JMUWRobotics/AMADEE-27/charging_station/KiCad/PIHAT/jlcpcb/production_files/BOM-PIHAT.csv

Comment | Designator | Footprint | LCSC | Quantity
100nF | C5 | C_0603_1608Metric | C14663 | 1
1nF | C4 | C_0603_1608Metric | C1588 | 1
470 | R1,R10,R11,R12,R13,R14,R16,R17,R20,R21,R22,R7,R8 | R_0603_1608Metric | C23179 | 13
5.1k | R15,R18,R19,R2,R3,R4,R5,R6,R9 | R_0603_1608Metric | C23186 | 9
5v(Vin) | J1 | TerminalBlock_Phoenix_PT-1,5-2-5.0-H_1x02_P5.00mm_Horizontal | C3819953 | 1
AO3400A | Q1,Q11,Q6,Q8 | SOT-23 | C20917 | 4
AO3401A | Q10,Q2,Q7,Q9 | SOT-23 | C15127 | 4
D_Schottky | D2 | D_SOD-323 | C7420360 | 1
GPIO | J9 | PinSocket_2x20_P2.54mm_Vertical | C6235776 | 1
IM03GR | U4 | RELAY-SMD_IMXXGR | C2153100 | 1
KT-0805G | D5,D6,D7 | LED_0805_2012Metric | C2297 | 3
KT-0805Y | D8 | LED_0805_2012Metric | C2296 | 1
M7 | D1 | D_SMA | C95872 | 1
MPPT | J2 | TerminalBlock_Phoenix_PT-1,5-2-5.0-H_1x02_P5.00mm_Horizontal | C3819953 | 1
MSK12C02G25-B | U1,U2,U3,U5 | SW-SMD_MSK12C02G25-B | C22435663 | 4
NCD0805R1 | D4 | LED_0805_2012Metric | C84256 | 1
PS | J3 | TerminalBlock_Phoenix_PT-1,5-2-5.0-H_1x02_P5.00mm_Horizontal | C3819953 | 1
RFID0 | J4 | JST_XH_S7B-XH-A_1x07_P2.50mm_Horizontal | C157916 | 1
RFID1 | J5 | JST_XH_S7B-XH-A_1x07_P2.50mm_Horizontal | C157916 | 1
RFID2 | J6 | JST_XH_S7B-XH-A_1x07_P2.50mm_Horizontal | C157916 | 1
Raspberry Control Signals | J7 | JST_XH_S7B-XH-A_1x07_P2.50mm_Horizontal | C157916 | 1
TLP293 | U10,U11,U12,U6,U8,U9 | SOIC-4_4.55x2.6mm_P1.27mm | C3008594 | 6
TPS3430WDRC | U7 | VSON-10-1EP_3x3mm_P0.5mm_EP1.65x2.4mm | C2870545 | 1
WD_F | J8 | TerminalBlock_Phoenix_PT-1,5-2-5.0-H_1x02_P5.00mm_Horizontal | C3819953 | 1
