JMUWRobotics/AMADEE-27/charging_station/KiCad/PIHAT/jlcpcb/production_files/BOM-PIHAT-rounded.csv

Comment | Designator | Footprint | LCSC | Quantity
100nF | C2,C5 | C_0603_1608Metric | C14663 | 2
10k | R4,R5,R6 | R_0805_2012Metric_Pad1.20x1.40mm_HandSolder | C17414 | 3
1nF | C4 | C_0603_1608Metric | C1588 | 1
200 | R10,R11,R3,R8,R9 | R_0603_1608Metric | C8218 | 5
5v(Vin) | J1 | TerminalBlock_Phoenix_PT-1,5-2-5.0-H_1x02_P5.00mm_Horizontal | C5188434 | 1
AO3400A | Q2,Q5,Q6,Q8 | SOT-23 | C20917 | 4
AO3401A | Q1,Q3,Q4,Q7 | SOT-23 | C15127 | 4
D_Schottky | D2 | D_SOD-323 | C7420360 | 1
GPIO | J9 | PinSocket_2x20_P2.54mm_Vertical | C6235776 | 1
Heartbeat | D5 | LED_0805_2012Metric | C2297 | 1
IM03GR | U4 | RELAY-SMD_IMXXGR | C2153100 | 1
M7 | D1 | D_SMA | C95872 | 1
MPPT | J2 | TerminalBlock_Phoenix_PT-1,5-2-5.0-H_1x02_P5.00mm_Horizontal | C5188434 | 1
MSK12C02G25-B | U1,U2,U3 | SW-SMD_MSK12C02G25-B | C22435663 | 3
PS | J3 | TerminalBlock_Phoenix_PT-1,5-2-5.0-H_1x02_P5.00mm_Horizontal | C5188434 | 1
RFID0 | J4 | JST_XH_S7B-XH-A_1x07_P2.50mm_Horizontal | C157916 | 1
RFID1 | J5 | JST_XH_S7B-XH-A_1x07_P2.50mm_Horizontal | C157916 | 1
RFID2 | J6 | JST_XH_S7B-XH-A_1x07_P2.50mm_Horizontal | C157916 | 1
Raspberry Control Signals | J7 | JST_XH_S7B-XH-A_1x07_P2.50mm_Horizontal | C157916 | 1
TLV809EA29DBZR | U6 | SOT-23-3_L2.9-W1.3-P0.95-LS2.4-BR | C1852110 | 1
TPS3430WDRC | U7 | VSON-10-1EP_3x3mm_P0.5mm_EP1.65x2.4mm | C2870545 | 1
WDO | D4 | LED_0805_2012Metric | C84256 | 1
WD_F | J8 | TerminalBlock_Phoenix_PT-1,5-2-5.0-H_1x02_P5.00mm_Horizontal | C5188434 | 1
WD_LED_EN | D3 | LED_0805_2012Metric | C2296 | 1
~{WDO} | TP3 | TestPoint_Pad_D1.0mm |  | 1
WD_EN | TP2 | TestPoint_Pad_D1.0mm |  | 1
SET0 | TP1 | TestPoint_Pad_D1.0mm |  | 1
