JMUWRobotics/AMADEE-27/charging_station/KiCad/SLCU/jlcpcb/production_files/BOM-TowerLightPCB.csv

Comment | Designator | Footprint | LCSC | Quantity
1.5k | R10,R11,R12,R13,R15,R16,R17,R18,R19,R20,R21,R22,R23,R24,R25,R26,R27,R4,R5,R6,R7,R8,R9 | R_0805_2012Metric_Pad1.20x1.40mm_HandSolder | C4310 | 23
100n | C10,C11,C4 | C_0805_2012Metric_Pad1.18x1.45mm_HandSolder | C49678 | 3
100nF X7R >16V | C6 | C_0805_2012Metric | C49678 | 1
10k | RN2,RN7,RN8,RN9 | RES-ARRAY-SMD_0603-8P-L3.2-W1.6-BL | C29718 | 4
12uH | L1 | L_12x12mm_H8mm | C338772 | 1
1k | RN1,RN3,RN4,RN5,RN6 | RES-ARRAY-SMD_0603-8P-L3.2-W1.6-BL | C20197 | 5
2.7k 1% | R3 | R_0805_2012Metric_Pad1.20x1.40mm_HandSolder | C17530 | 1
22uF X7R >25V | C7,C8,C9 | C_0805_2012Metric_Pad1.18x1.45mm_HandSolder | C45783 | 3
2N7002 | Q10,Q11,Q12,Q13,Q14,Q15,Q16,Q17,Q18,Q19,Q2,Q20,Q21,Q22,Q23,Q24,Q25,Q26,Q27,Q28,Q29,Q3,Q30,Q4,Q5,Q6,Q7,Q8,Q9 | SOT-323_SC-70 | C7420322 | 29
4.7uF X7R >50V ~10mOhm | C5 | C_1206_3216Metric | C29823 | 1
51k | R14 | R_0805_2012Metric_Pad1.20x1.40mm_HandSolder | C17737 | 1
51k 1% | R2 | R_0805_2012Metric_Pad1.20x1.40mm_HandSolder | C17737 | 1
BAT54CDW | D13,D15,D19,D24,D30,D5,D8 | SOT-363_SC-70-6 | C49190672 | 7
CD4028BNSR | U2 | SOIC127P780X200-16N | C131484 | 1
CD4069UBNSR | U3 | SOIC127P780X200-14N | C2866535 | 1
Contact Signals | J2 | TerminalBlock_Phoenix_MKDS-1,5-4_1x04_P5.00mm_Horizontal | C3817931 | 1
E-STOP | D7 | LED_0805_2012Metric_Pad1.15x1.40mm_HandSolder | C84256 | 1
EN_LOGIC | D17 | LED_0805_2012Metric_Pad1.15x1.40mm_HandSolder | C2297 | 1
Enable Logic | SW1 | SW-SMD_SHOUHAN_MST-22D18G23J_C2875122 | C2875122 | 1
F1 | D16 | LED_0805_2012Metric_Pad1.15x1.40mm_HandSolder | C84256 | 1
F2 | D18 | LED_0805_2012Metric_Pad1.15x1.40mm_HandSolder | C84256 | 1
F3 | D20 | LED_0805_2012Metric_Pad1.15x1.40mm_HandSolder | C84256 | 1
F4 | D21 | LED_0805_2012Metric_Pad1.15x1.40mm_HandSolder | C84256 | 1
Input Power (24V) | J1 | TerminalBlock_Phoenix_MKDS-1,5-4_1x04_P5.00mm_Horizontal | C3817931 | 1
LED | D25,D26 | LED_0805_2012Metric_Pad1.15x1.40mm_HandSolder | C2296 | 2
LED | D27,D28,D29 | LED_0805_2012Metric_Pad1.15x1.40mm_HandSolder | C2297 | 3
LED | D22,D23 | LED_0805_2012Metric_Pad1.15x1.40mm_HandSolder | C84256 | 2
LMR51430 | U1 | SOT-23-6 | C5185863 | 1
Logic Power Out | J4 | TerminalBlock_Phoenix_MKDS-1,5-4_1x04_P5.00mm_Horizontal | C3817931 | 1
M7 | D1 | D_SMA | C95872 | 1
NOMINAL_ON | D14 | LED_0805_2012Metric_Pad1.15x1.40mm_HandSolder | C2297 | 1
PWR +12V | D4 | LED_0805_2012Metric_Pad1.15x1.40mm_HandSolder | C2297 | 1
PWR +24V | D3 | LED_0805_2012Metric_Pad1.15x1.40mm_HandSolder | C2297 | 1
READY | D6 | LED_0805_2012Metric_Pad1.15x1.40mm_HandSolder | C2297 | 1
Raspberry Control Signals | J3 | JST_XH_S7B-XH-A_1x07_P2.50mm_Horizontal | C157916 | 1
STOPPED | D11 | LED_0805_2012Metric_Pad1.15x1.40mm_HandSolder | C2297 | 1
Stack Light DOWN | J6 | TerminalBlock_Phoenix_MKDS-1,5-4_1x04_P5.00mm_Horizontal | C3817931 | 1
Stack Light UP | J5 | TerminalBlock_Phoenix_MKDS-1,5-4_1x04_P5.00mm_Horizontal | C3817931 | 1
WD | D9 | LED_0805_2012Metric_Pad1.15x1.40mm_HandSolder | C84256 | 1
XF-508P-A-B | F1 | FUSE-TH_XF-508P-A-B | C19727304 | 1
~{P1} | D12 | LED_0805_2012Metric_Pad1.15x1.40mm_HandSolder | C84256 | 1
~{P2} | D10 | LED_0805_2012Metric_Pad1.15x1.40mm_HandSolder | C84256 | 1
