JMUWRobotics/AMADEE-27/charging_station/QElectroTech/chargingStationV2.pdf

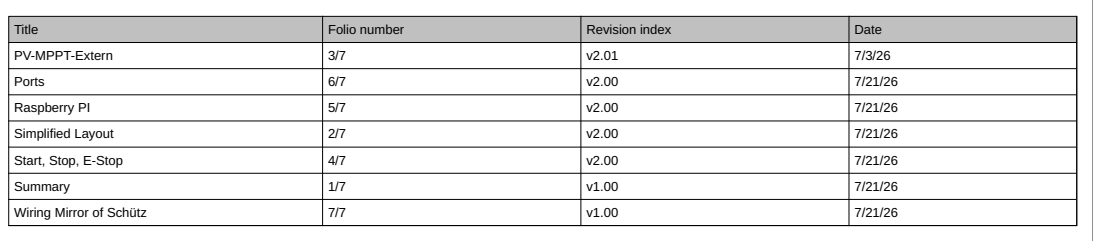
[picture p1: page 1]
Author:; Folio: 1/7; Date: 7/21/26; Summary; Save Date: 8/10/26; Revision: v1.00; PV-MPPT-Extern; Ports; Raspberry PI; Simplified Layout; Start, Stop, E-Stop; Wiring Mirror of Schütz; Title; Folio number; Revision index; Date

Charching Station AMADEE-27

File: ./charging_station/QElectroTech/chargingStation.qet

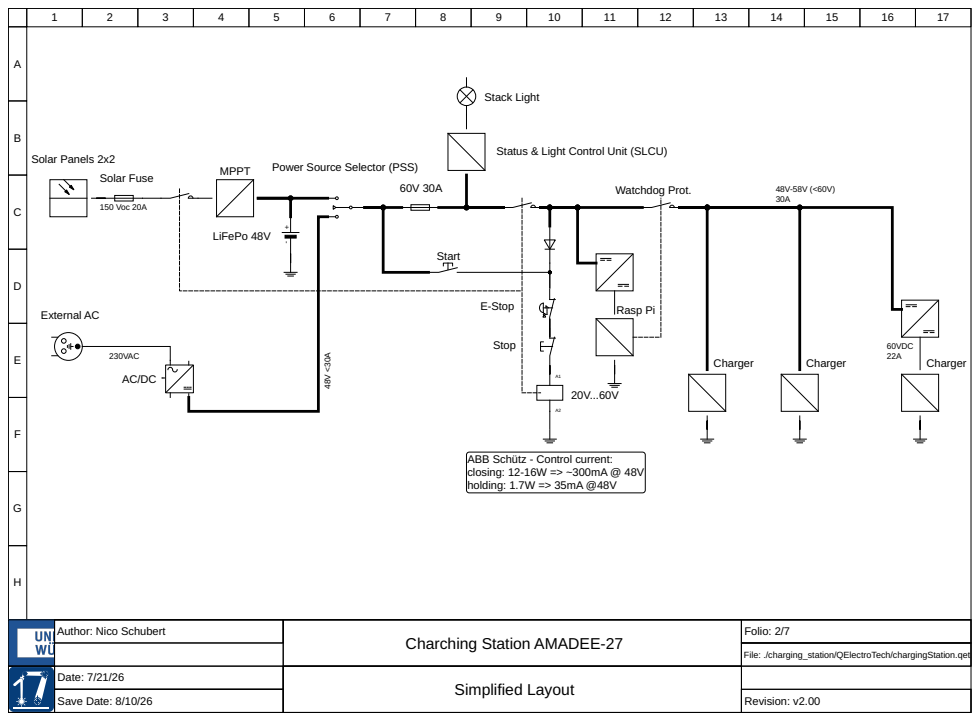
[picture p2: page 2]
Folio: 2/7; Date: 7/21/26; Simplified Layout; Save Date: 8/10/26; Revision: v2.00; Watchdog Prot.; Stop; Solar Panels 2x2; Charger; Start; Solar Fuse; MPPT; LiFePo 48V; Stack Light; 150 Voc 20A; 230VAC; 60VDC 22A; E-Stop

Status & Light Control Unit (SLCU)

Power Source Selector (PSS)

Rasp Pi External AC

ABB Schütz - Control current:
closing: 12-16W => ~300mA @ 48V
holding: 1.7W => 35mA @48V

Author: Nico Schubert

Charching Station AMADEE-27

File: ./charging_station/QElectroTech/chargingStation.qet

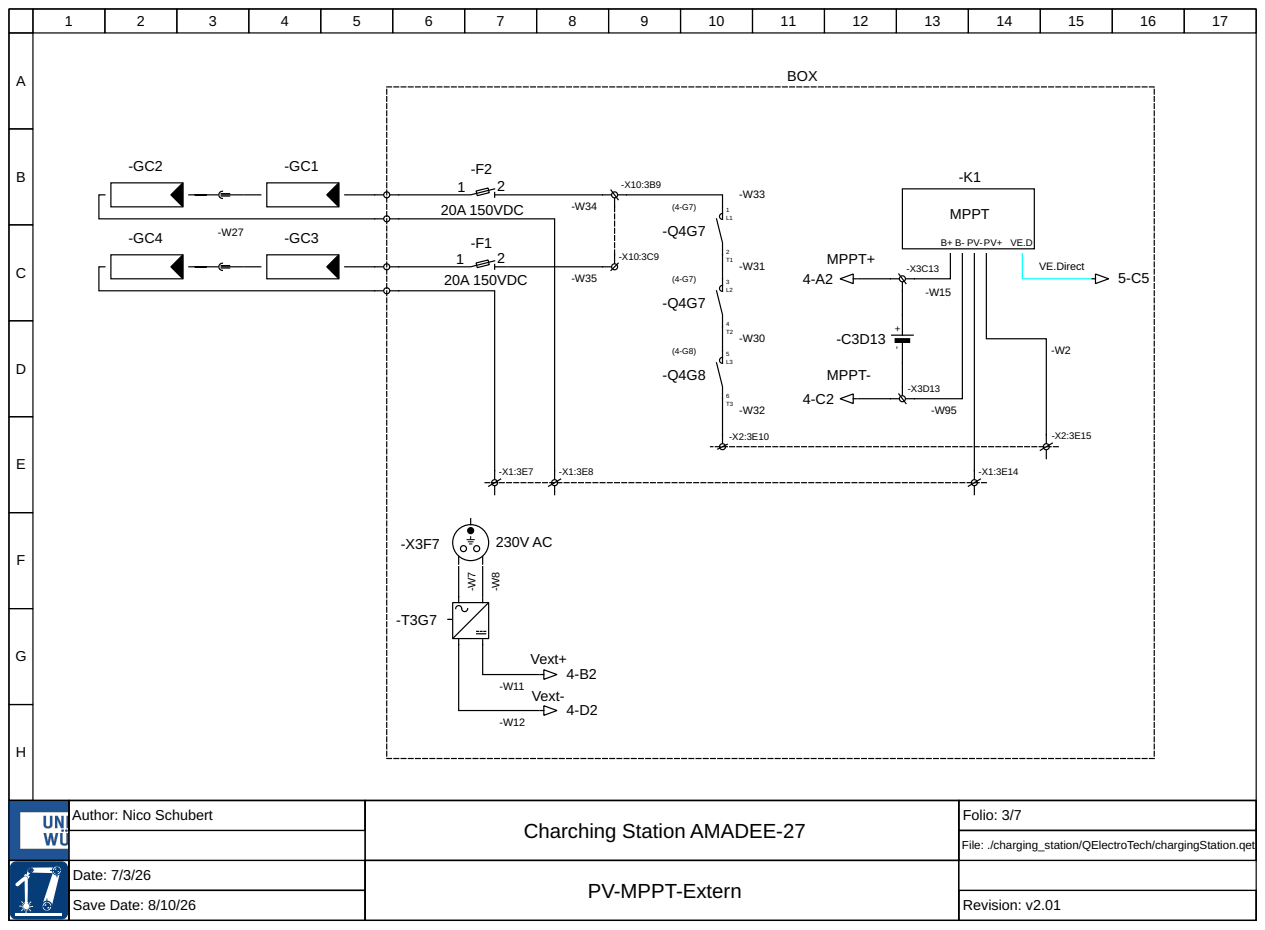
[picture p3: page 3]
Folio: 3/7; Date: 7/3/26; MPPT-; 20A 150VDC; MPPT; Vext-; MPPT+; Vext+; BOX; VE.Direct

Author: Nico Schubert

Charching Station AMADEE-27

File: ./charging_station/QElectroTech/chargingStation.qet

PV-MPPT-Extern

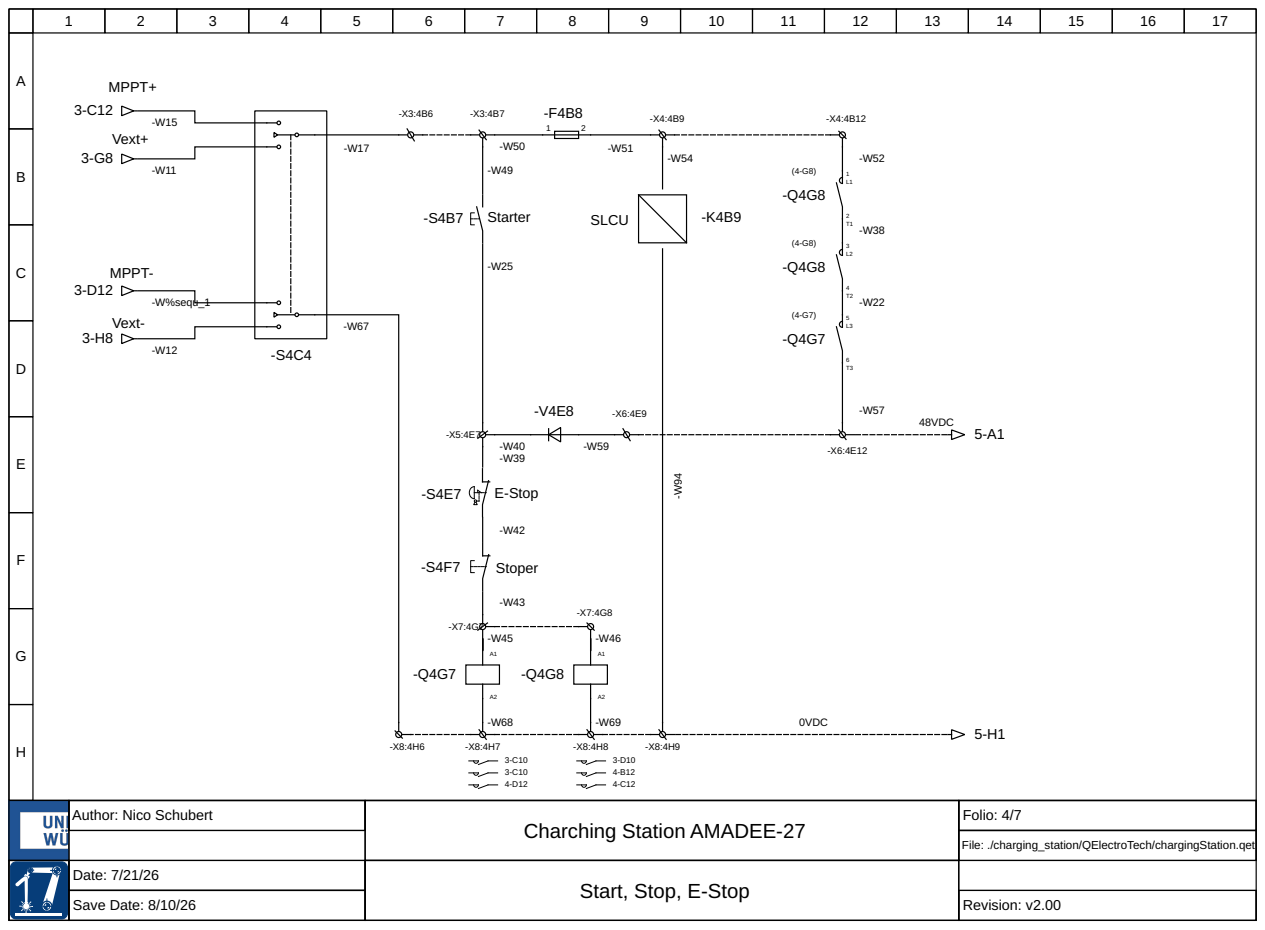
[picture p4: page 4]
Charching Station AMADEE-27; Folio: 4/7; Date: 7/21/26; MPPT+; Vext+; Vext-; MPPT-; E-Stop; Starter; Stoper; SLCU; -W%sequ_1; 48VDC; 0VDC

Author: Nico Schubert

File: ./charging_station/QElectroTech/chargingStation.qet

Start, Stop, E-Stop

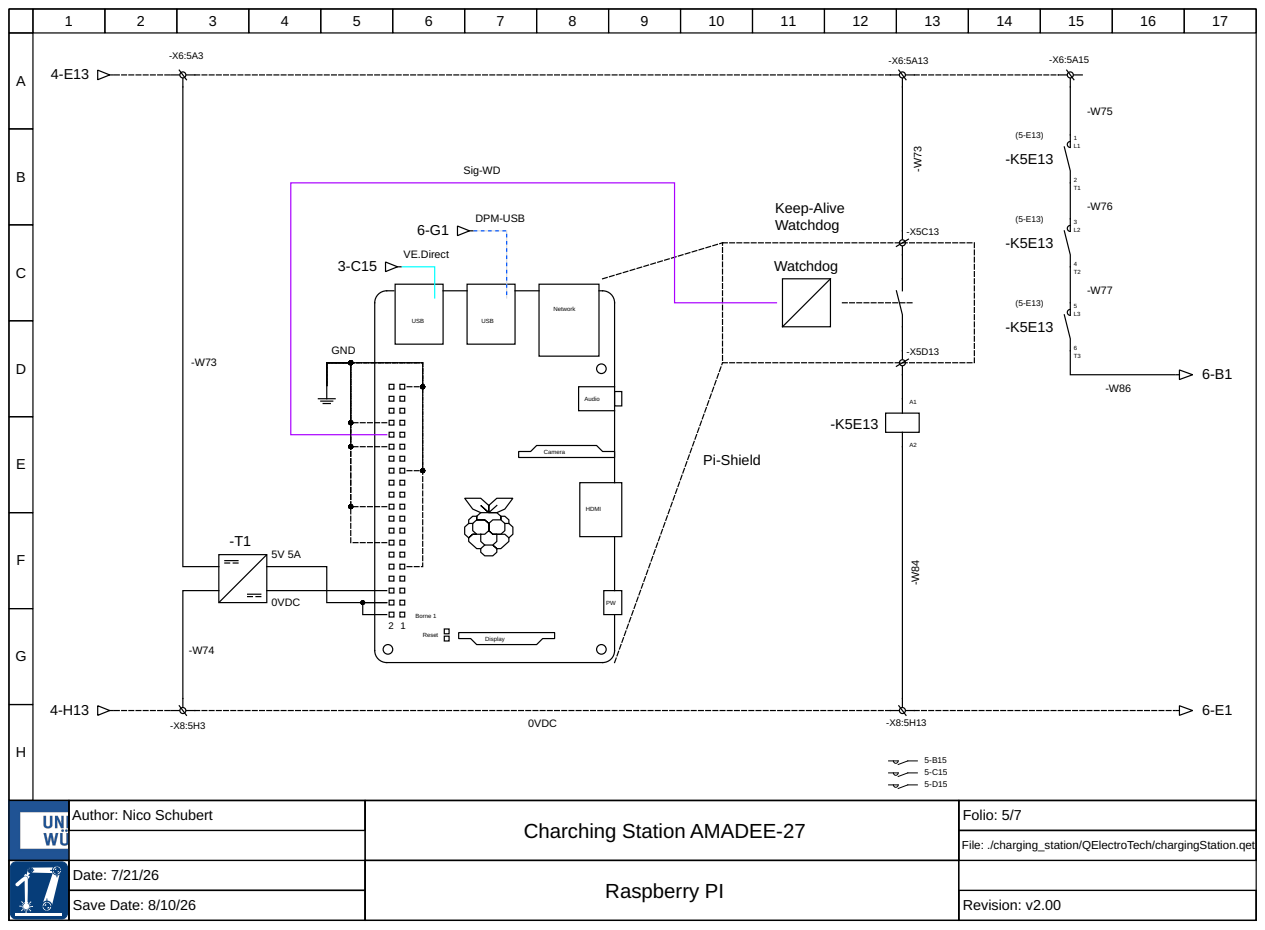
[picture p5: page 5]
Folio: 5/7; Date: 7/21/26; Raspberry PI; USB; Network; Audio; Camera; HDMI; Display; Borne 1; Reset; Watchdog; Keep-Alive Watchdog; Pi-Shield; DPM-USB; 0VDC; GND; Sig-WD; VE.Direct

Author: Nico Schubert

Charching Station AMADEE-27

File: ./charging_station/QElectroTech/chargingStation.qet

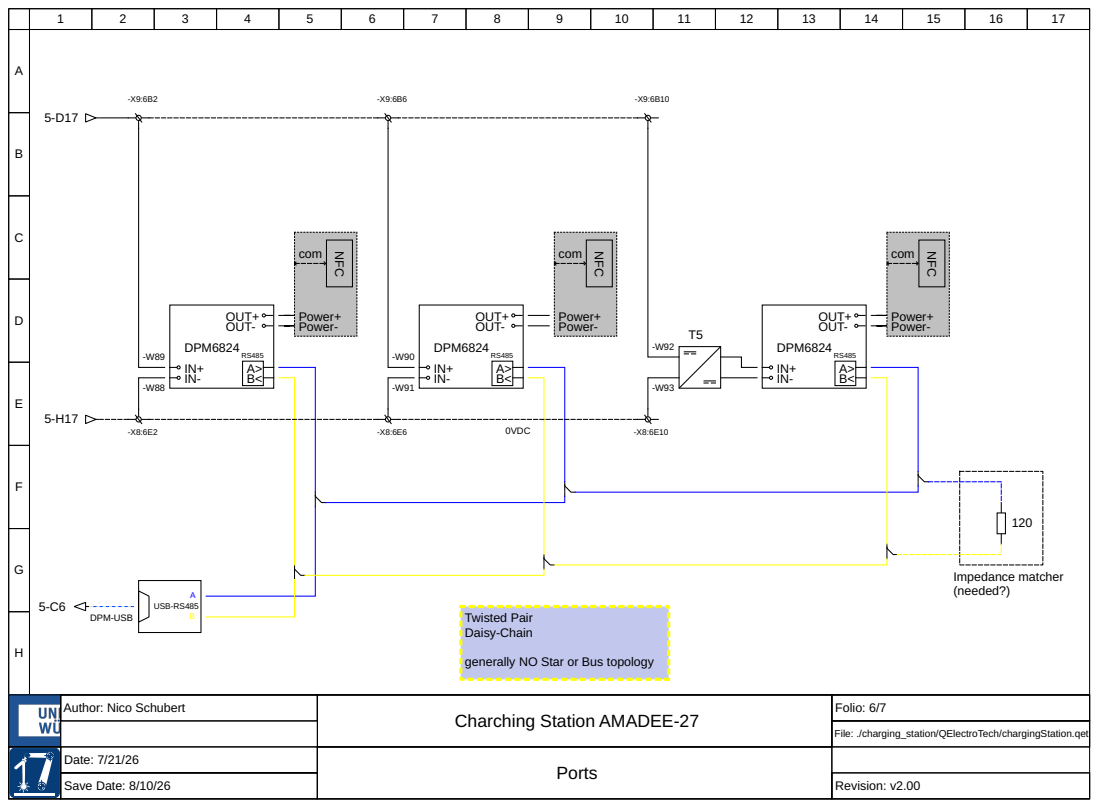
[picture p6: page 6]
Folio: 6/7; Date: 7/21/26; Ports; USB-RS485; Twisted Pair; Daisy-Chain; Impedance matcher (needed?); OUT+; OUT- RS485 DPM6824; Power+ Power-; NFC; com; DPM-USB; 0VDC

generally NO Star or Bus topology

Author: Nico Schubert

Charching Station AMADEE-27

File: ./charging_station/QElectroTech/chargingStation.qet

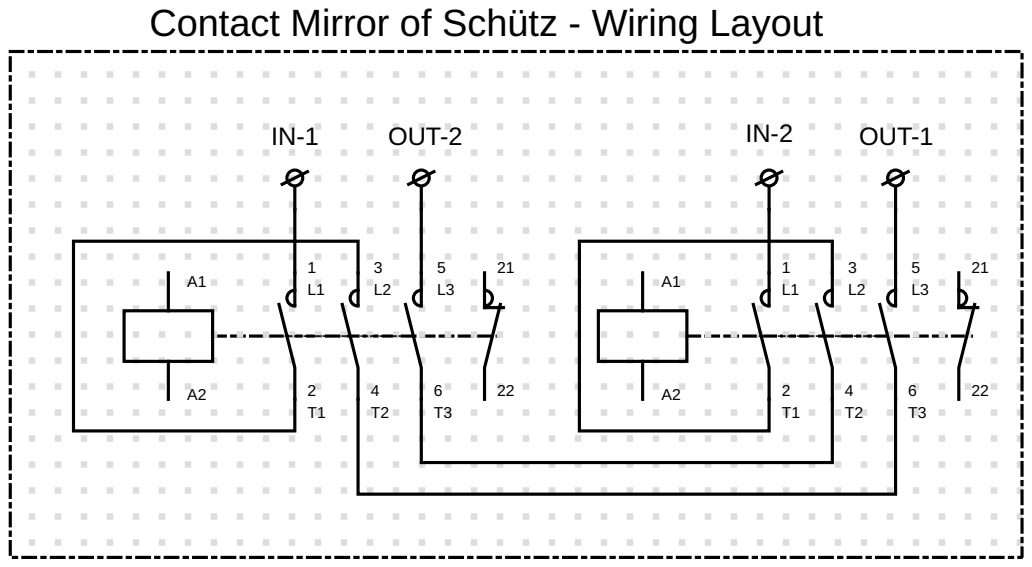
[picture p7: page 7]
Folio: 7/7; Date: 7/21/26; Save Date: 8/10/26; Revision: v1.00; OUT-2; OUT-1

Contact Mirror of Schütz - Wiring Layout

Author: Nico Schubert

Charching Station AMADEE-27

File: ./charging_station/QElectroTech/chargingStation.qet

Wiring Mirror of Schütz
