JMUWRobotics/AMADEE-27/charging_station/KiCad/PIHAT/PIHAT-schematic.pdf

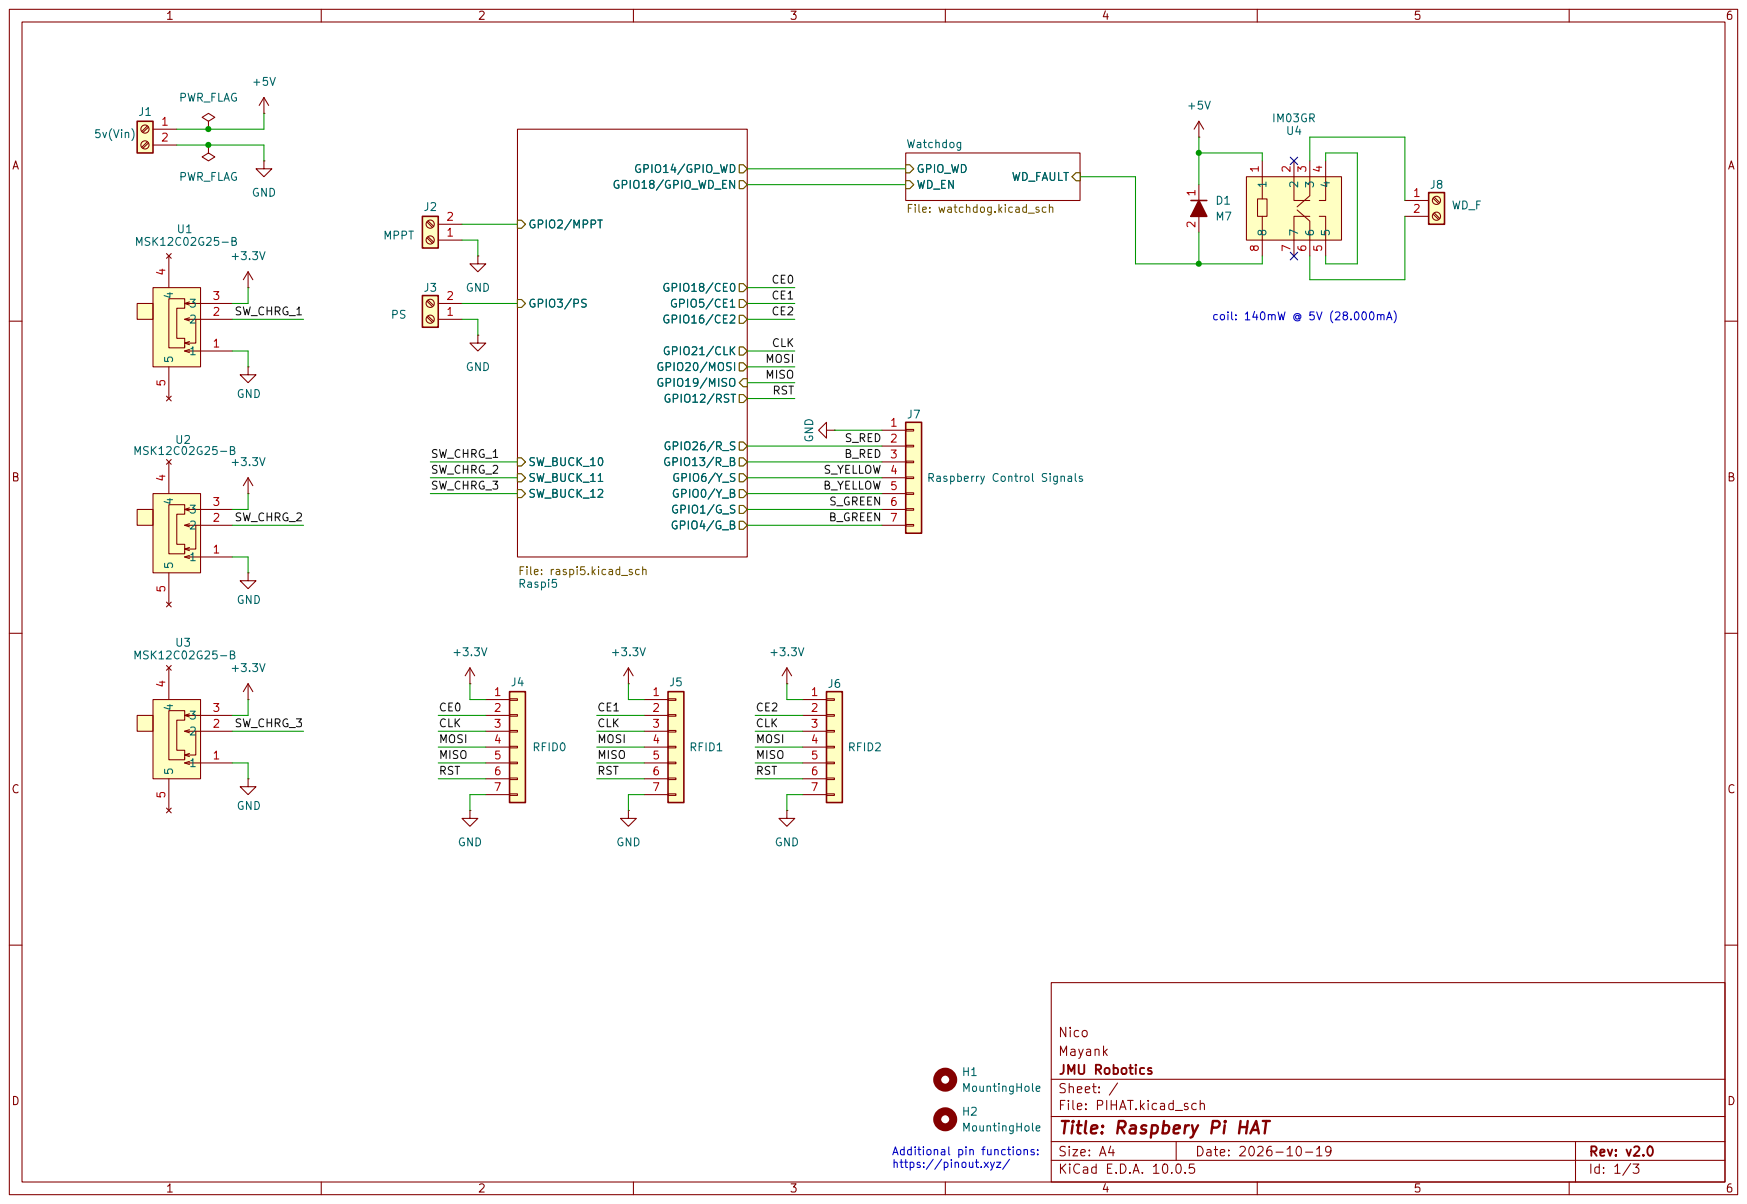
[picture p8: page 1]

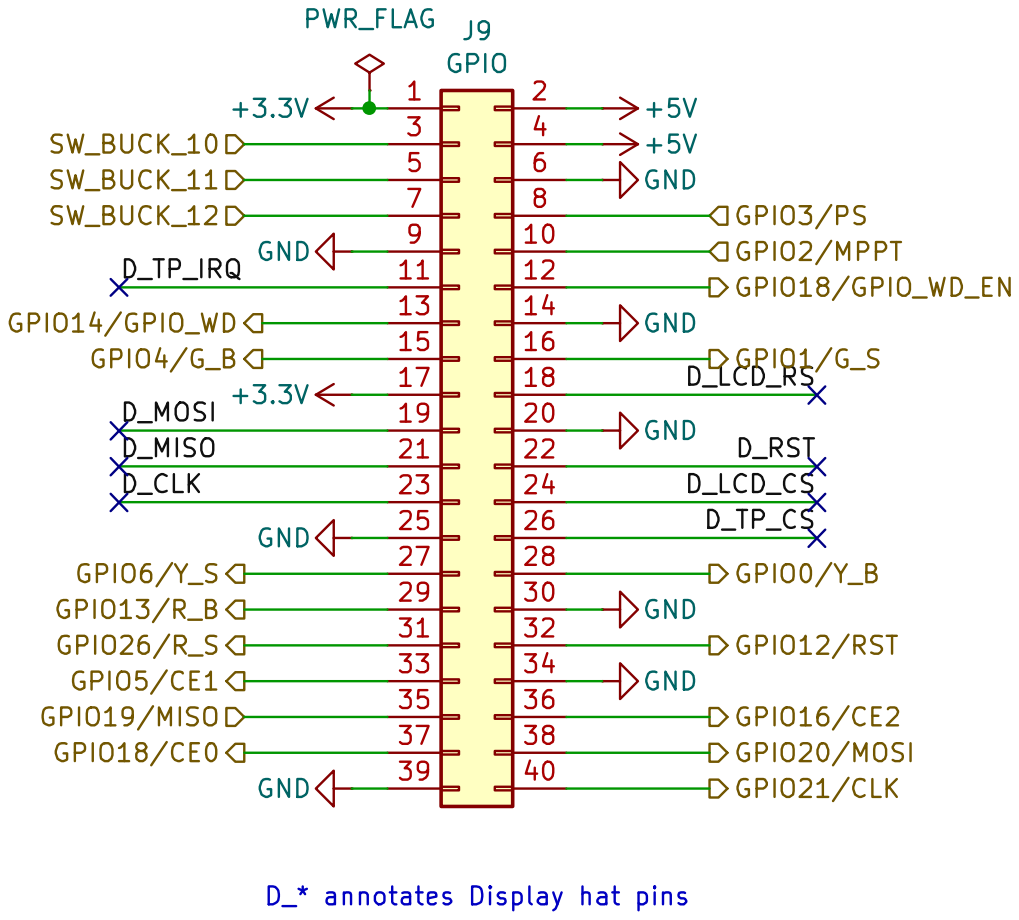
[picture p9: page 2]

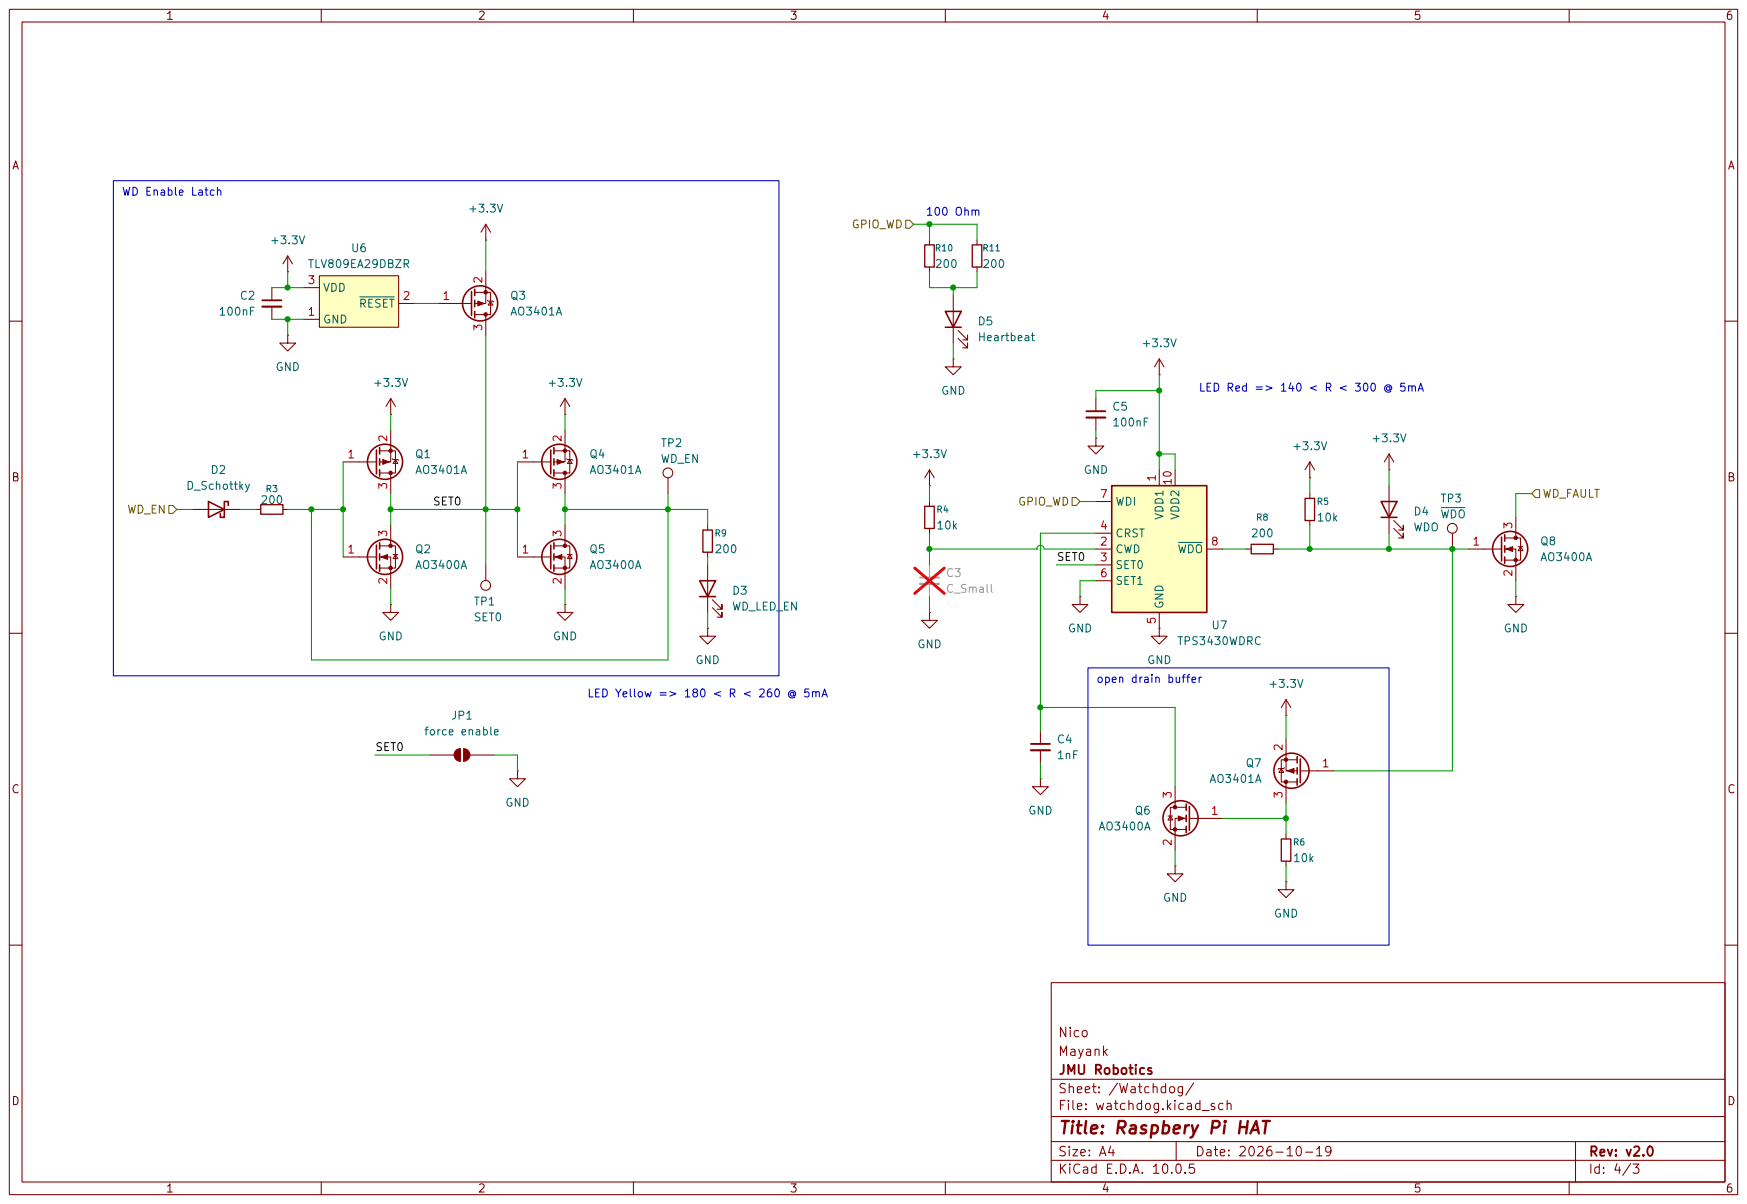
[picture p10: page 3]
