JMUWRobotics/AMADEE-27/charging_station/KiCad/PIHAT/PIHAT-pdb-back.pdf

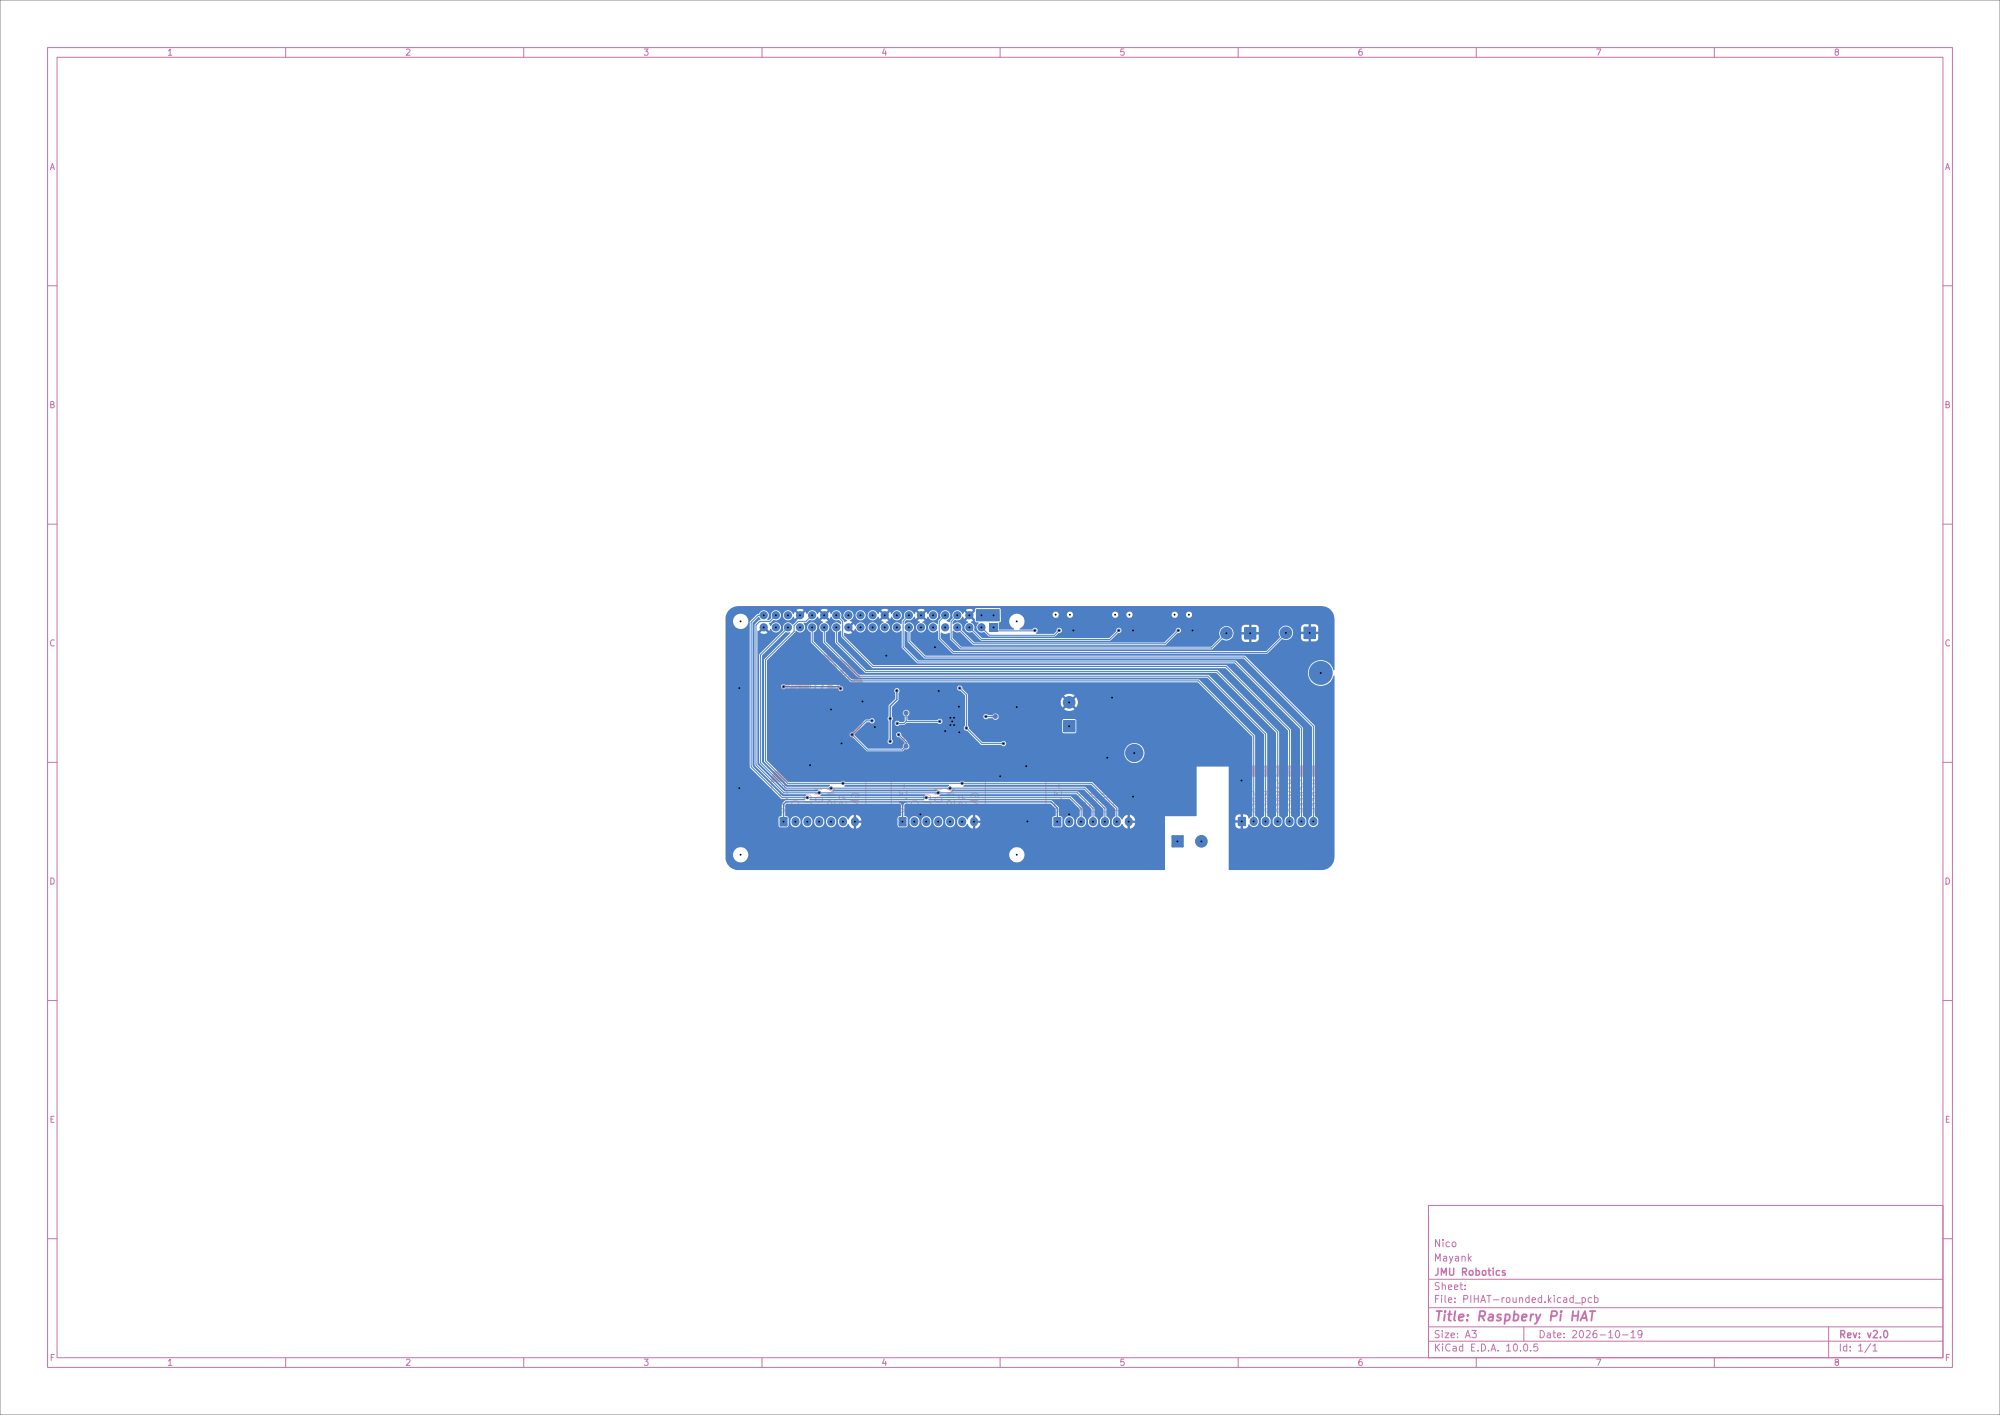
[picture p18: page 1]
