JMUWRobotics/AMADEE-27/charging_station/KiCad/PIHAT/PIHAT-pdb-front.pdf

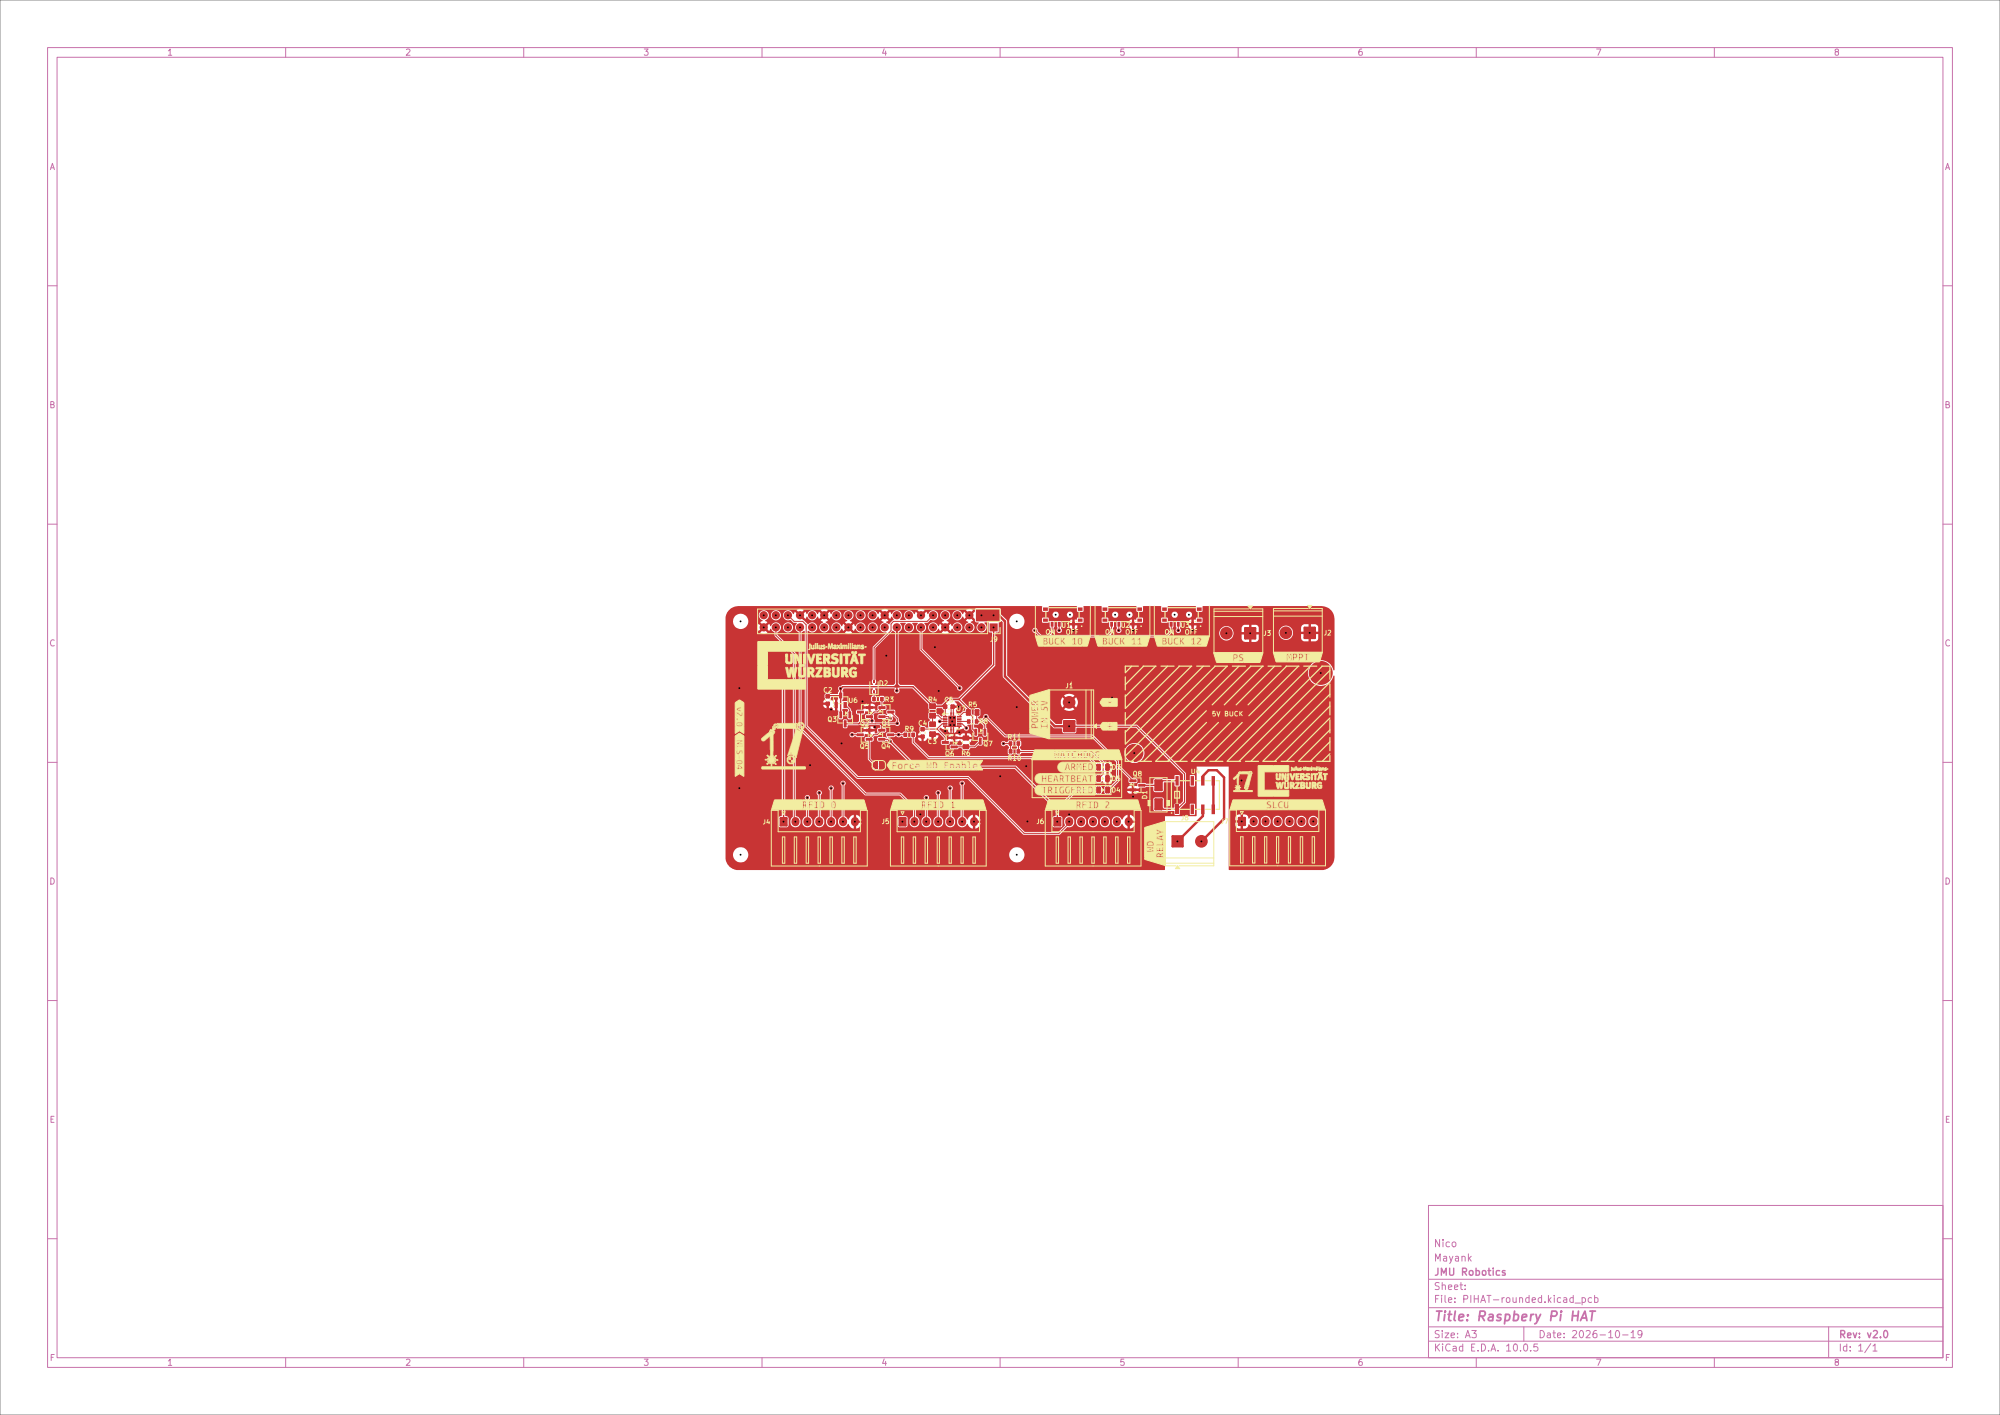
[picture p19: page 1]
