JMUWRobotics/AMADEE-27/charging_station/KiCad/SLCU/SLCU-pcb-back.pdf

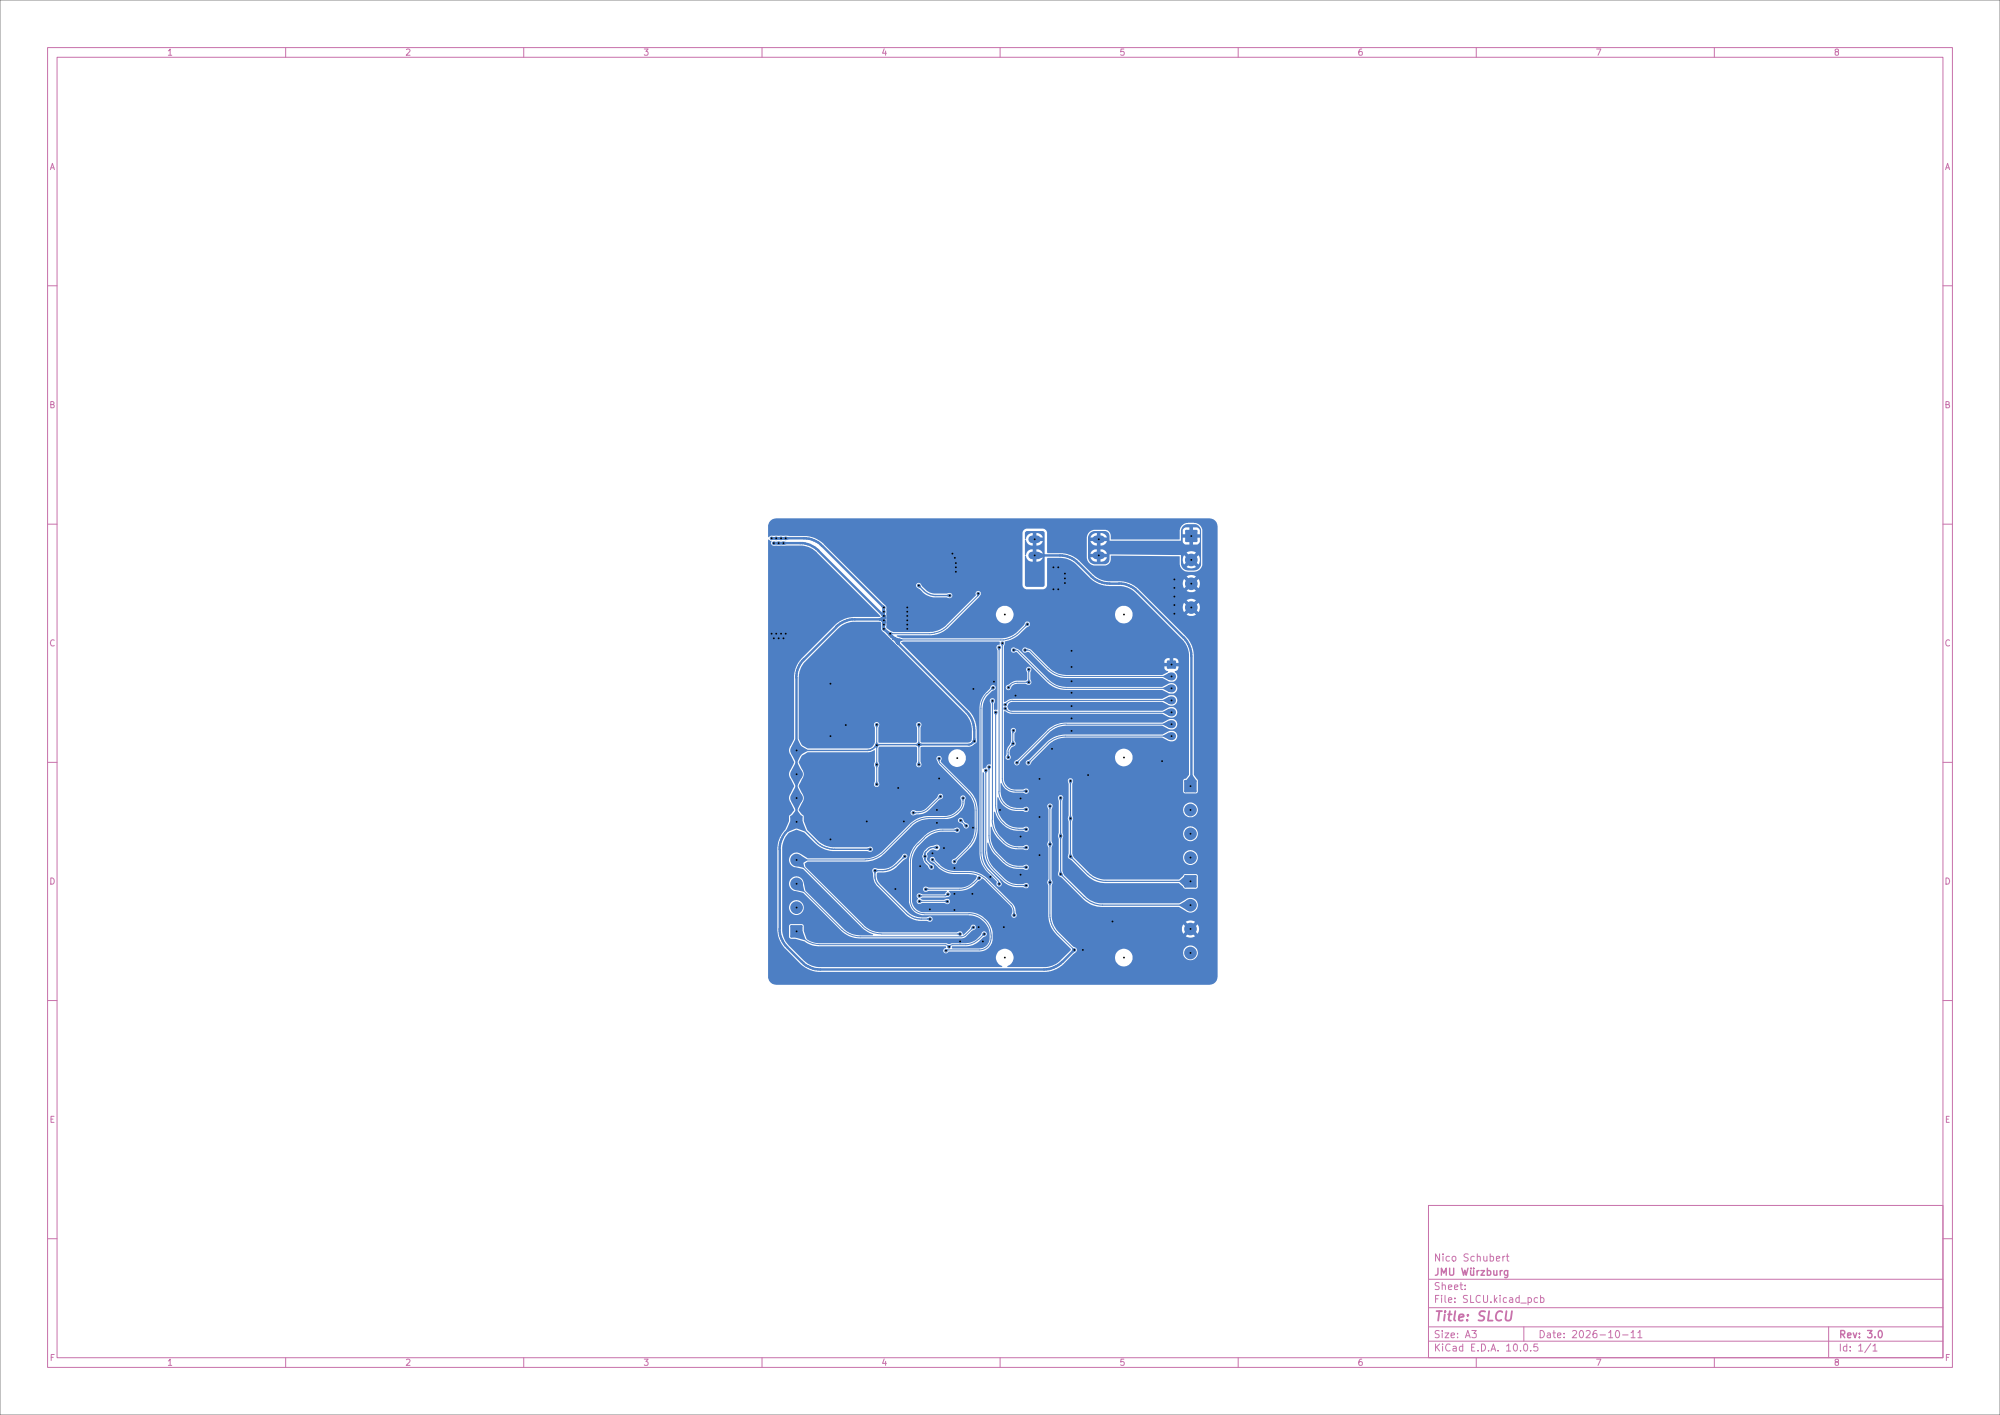
[picture p20: page 1]
