JMUWRobotics/AMADEE-27/charging_station/KiCad/SLCU/SLCU-pcb-front.pdf

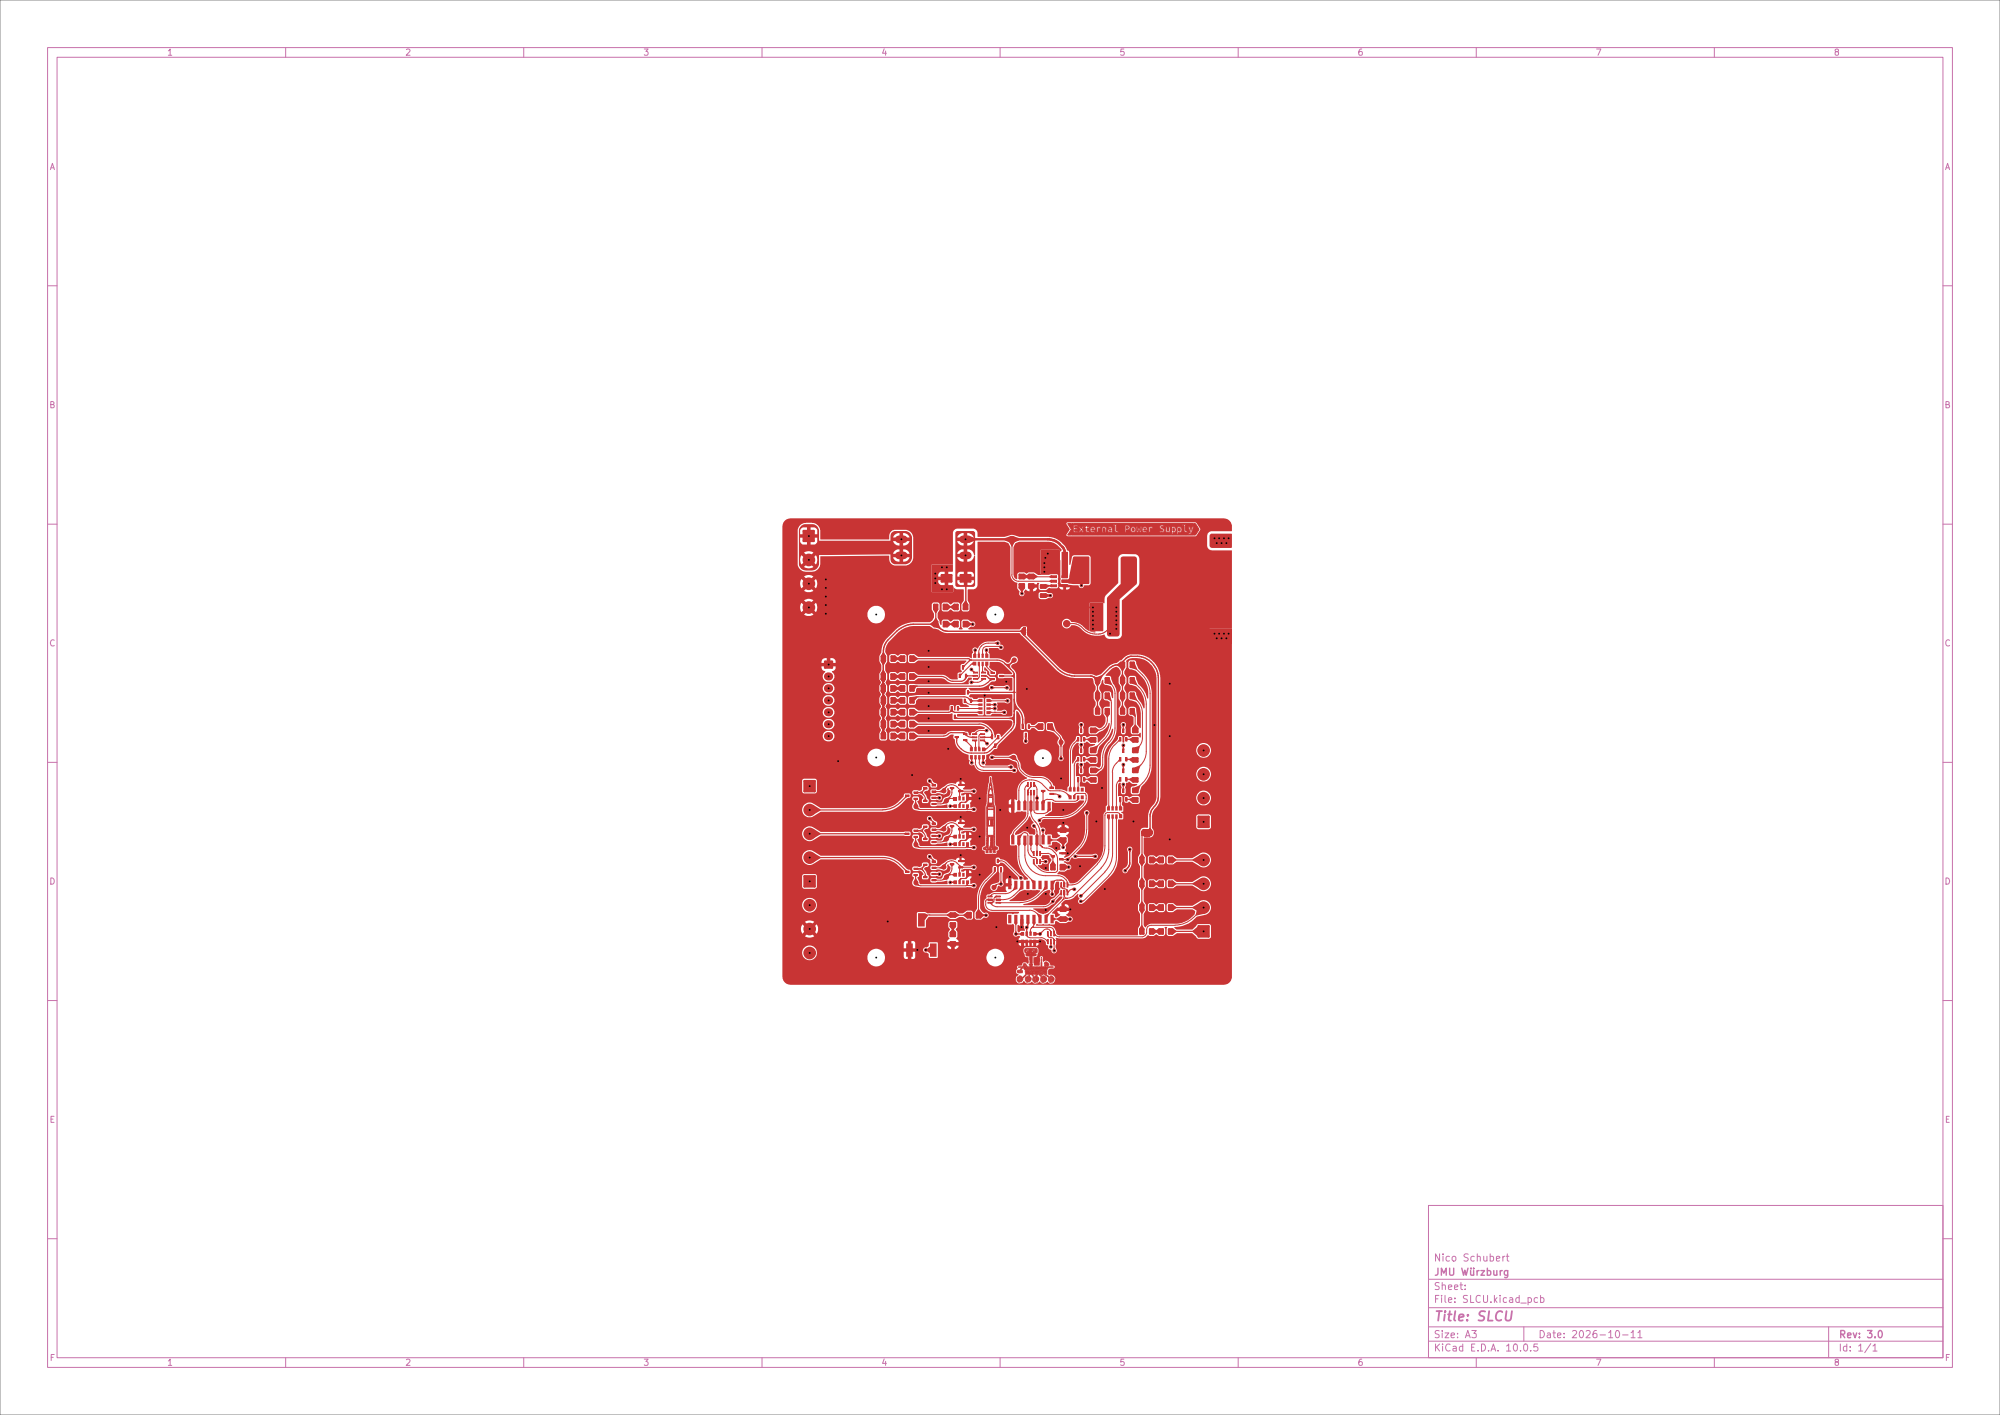
[picture p21: page 1]
