JMUWRobotics/AMADEE-27/charging_station/QElectroTech/chargingStation.pdf

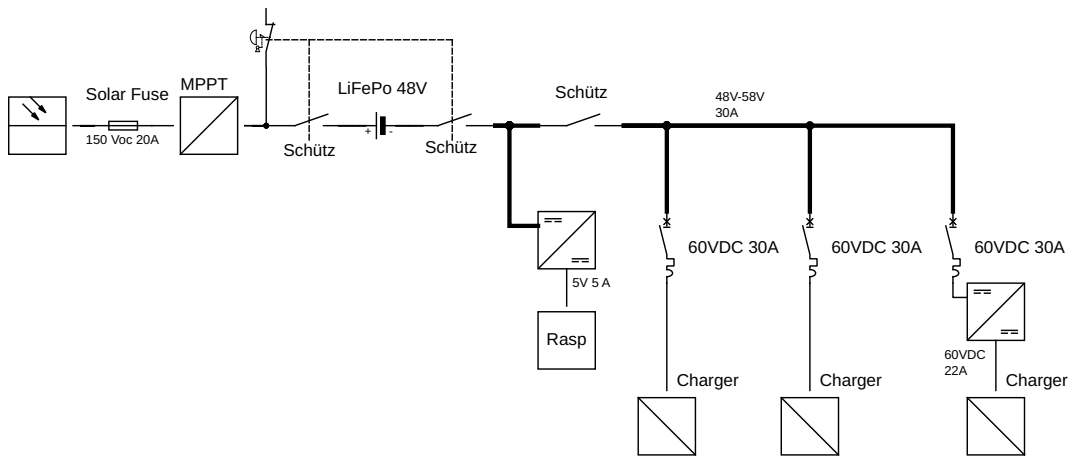
[picture p22: page 1]
Folio: 1/4; Date: 7/3/26; Simplified Layout; Save Date: 7/3/26; Revision: v1.02; MPPT; Solar Fuse; LiFePo 48V; Rasp; Schütz; Charger; 60VDC 30A; 150 Voc 20A; 60VDC 22A

Author: Nico Schubert

Charching Station AMADEE-27

File: ./charging_station/QElectroTech/chargingStation.qet

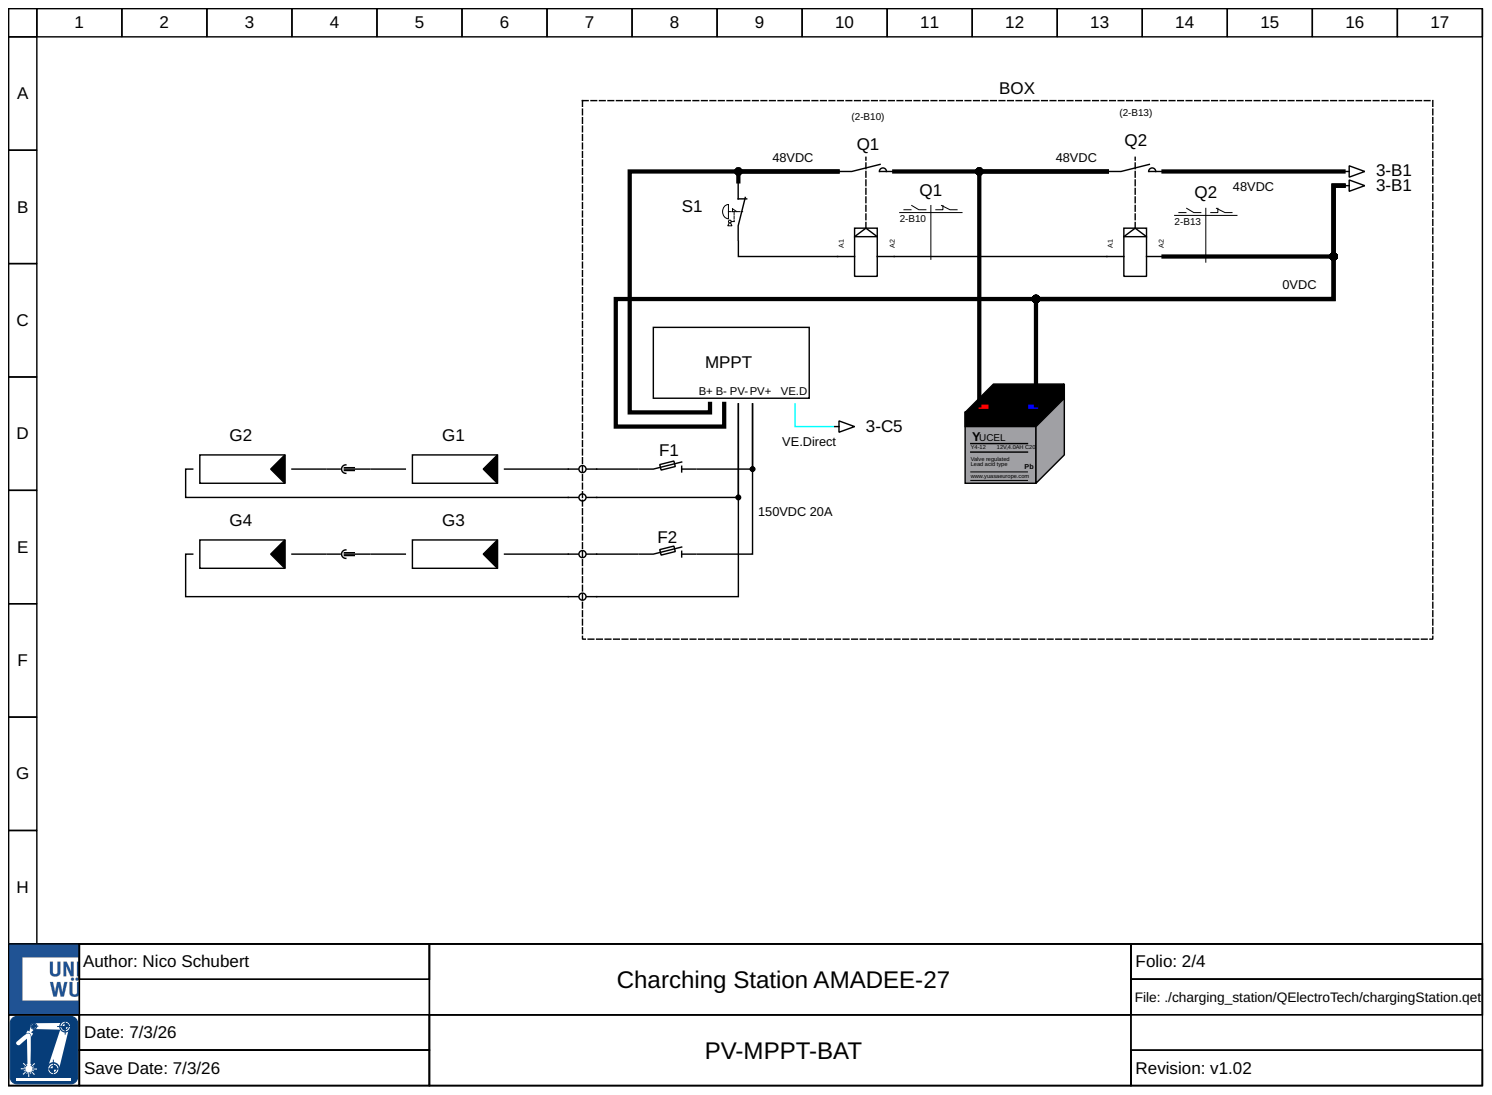
[picture p23: page 2]
Folio: 2/4; Date: 7/3/26; MPPT; YUCEL; Lead acid type; BOX; 0VDC; VE.Direct; 48VDC; 150VDC 20A

Valve regulated
www.yuasaeurope.com

Author: Nico Schubert

Charching Station AMADEE-27

File: ./charging_station/QElectroTech/chargingStation.qet

PV-MPPT-BAT

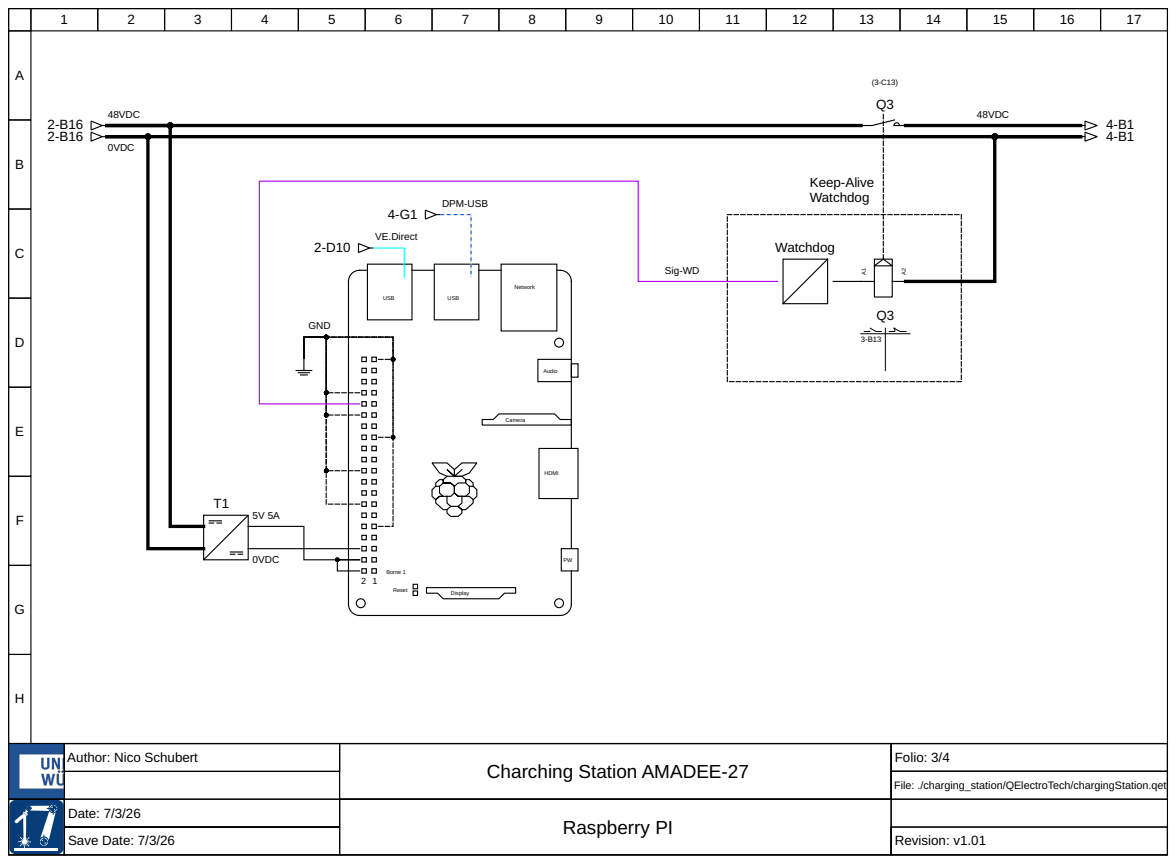
[picture p24: page 3]
Folio: 3/4; Date: 7/3/26; Raspberry PI; USB; Network; Audio; Camera; HDMI; Display; Borne 1; Reset; Watchdog; Keep-Alive Watchdog; 0VDC; VE.Direct; DPM-USB; 48VDC; GND; Sig-WD

Author: Nico Schubert

Charching Station AMADEE-27

File: ./charging_station/QElectroTech/chargingStation.qet

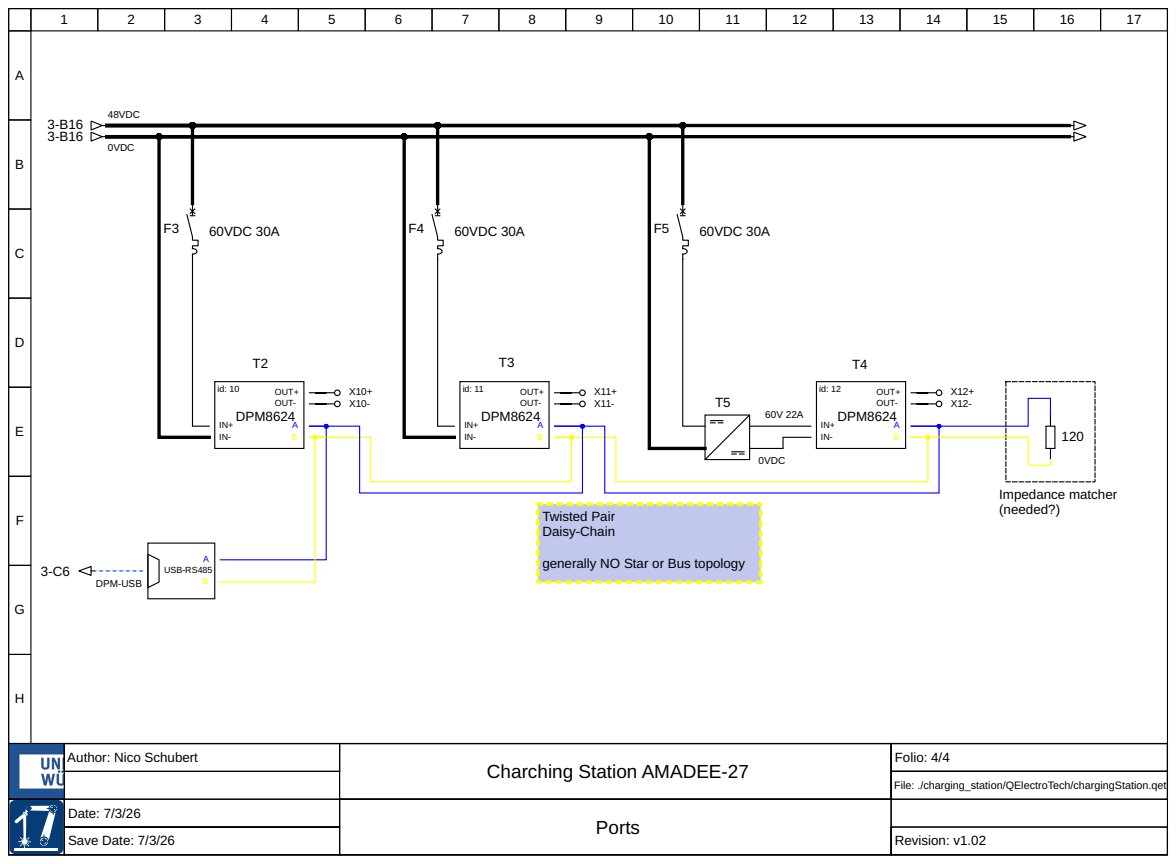
[picture p25: page 4]
Folio: 4/4; Date: 7/3/26; Ports; DPM8624 A B; OUT+ OUT-; Twisted Pair Daisy-Chain; Impedance matcher (needed?); 60VDC 30A; USB-RS485; 0VDC; 48VDC; DPM-USB

generally NO Star or Bus topology

Author: Nico Schubert

Charching Station AMADEE-27

File: ./charging_station/QElectroTech/chargingStation.qet
