JMUWRobotics/AMADEE-27/charging_station/KiCad/PIHAT/PIHAT.kicad_pcb

## KiCad design charging_station/KiCad/PIHAT/PIHAT.kicad_pcb (2026-11-14)

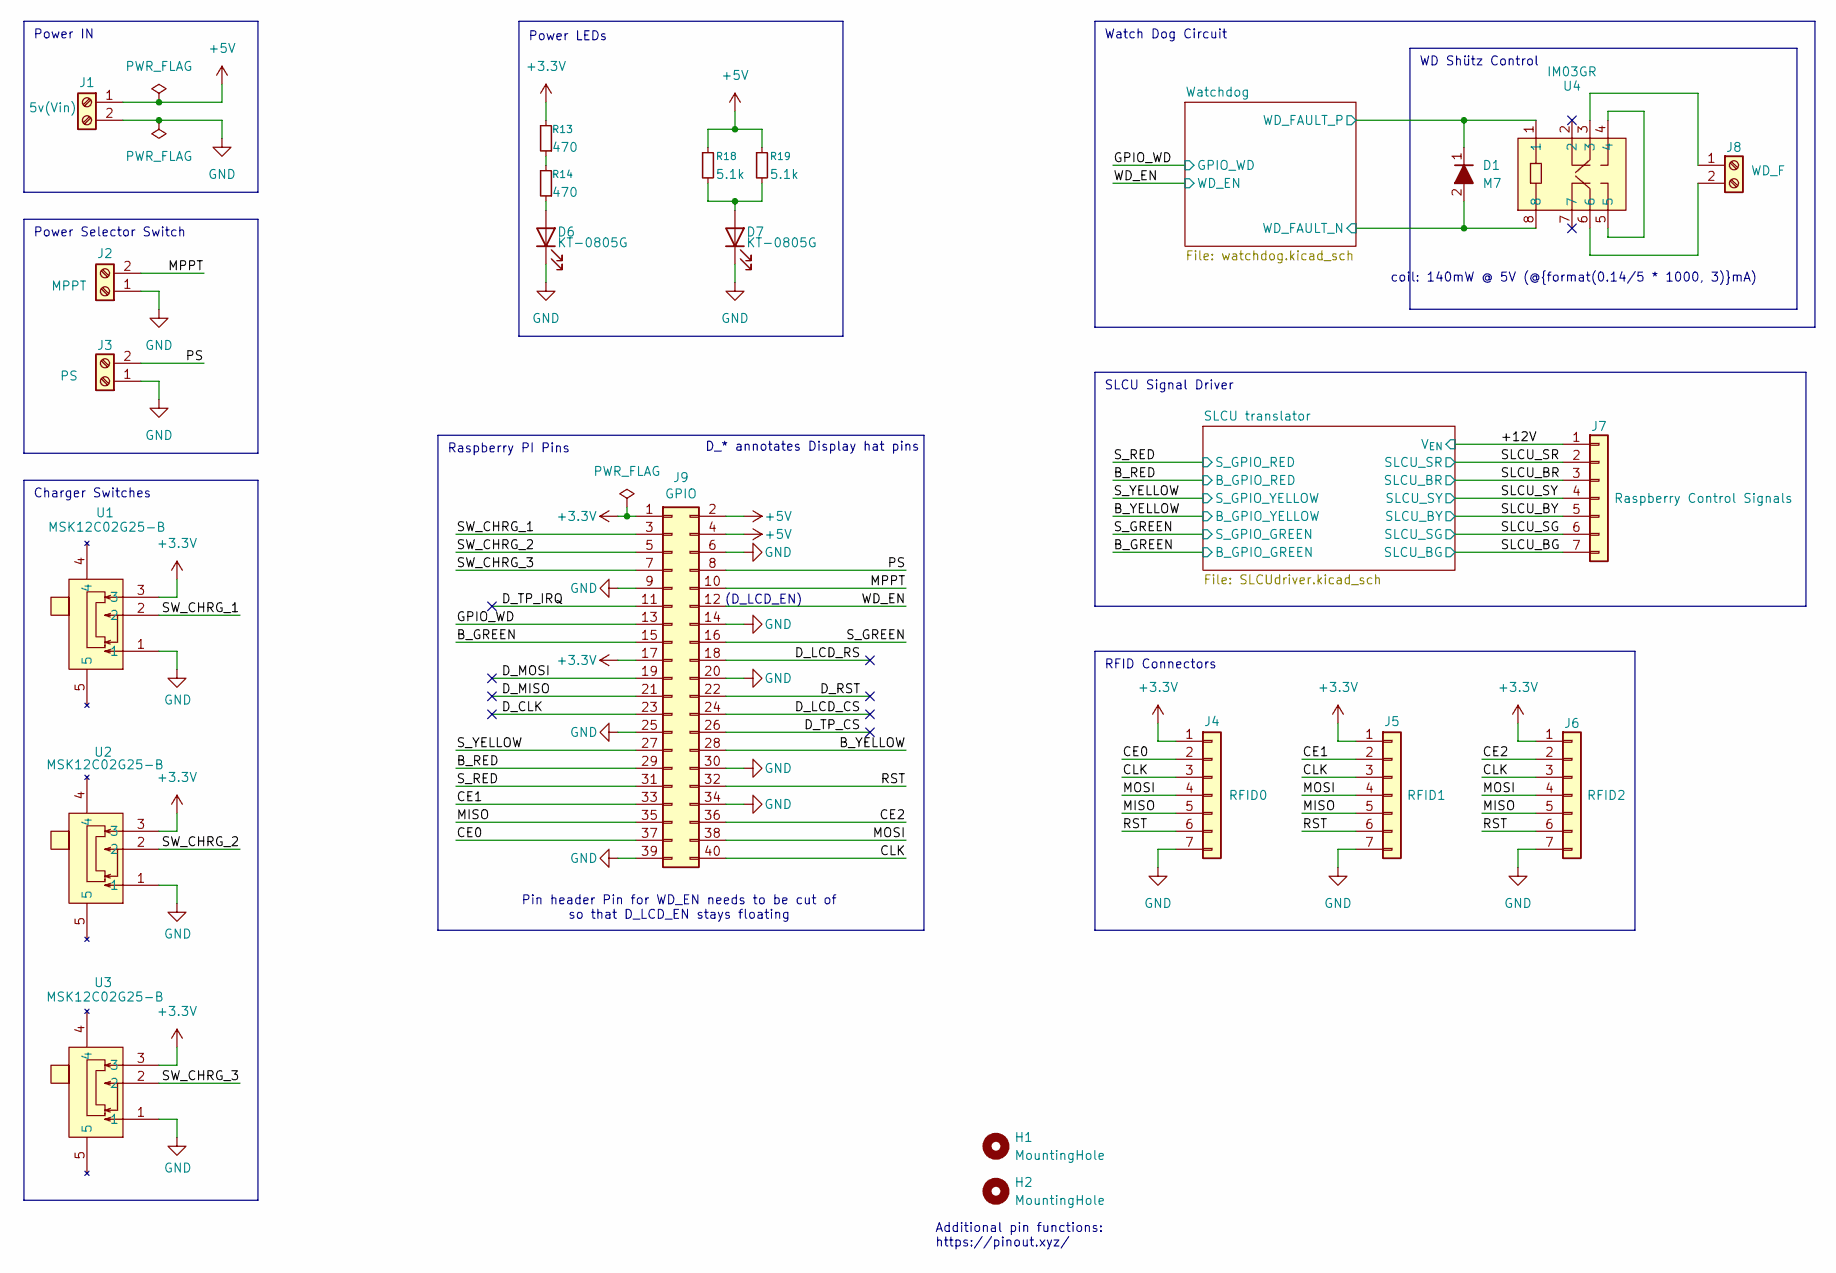
[picture p26: schematic PIHAT.kicad_sch, Raspbery Pi HAT]

Parts:
D1: M7; D_SMA; MPN M7; LCSC Part C95872
D6, D7: KT-0805G; LED_0805_2012Metric; MPN KT-0805G; LCSC Part C2297
H1: MountingHole; MountingHole_2.2mm_M2_DIN965_Pad
H2: MountingHole; MountingHole_2.5mm_Pad
J1: 5v(Vin); TerminalBlock_Phoenix_PT-1,5-2-5.0-H_1x02_P5.00mm_Horizontal; MPN 1935161; LCSC Part C3819953
J2: MPPT; TerminalBlock_Phoenix_PT-1,5-2-5.0-H_1x02_P5.00mm_Horizontal; MPN 1935161; LCSC Part C3819953
J3: PS; TerminalBlock_Phoenix_PT-1,5-2-5.0-H_1x02_P5.00mm_Horizontal; MPN 1935161; LCSC Part C3819953
J4: RFID0; JST_XH_S7B-XH-A_1x07_P2.50mm_Horizontal; MPN S7B-XH-A(LF)(SN); LCSC Part C157916
J5: RFID1; JST_XH_S7B-XH-A_1x07_P2.50mm_Horizontal; MPN S7B-XH-A(LF)(SN); LCSC Part C157916
J6: RFID2; JST_XH_S7B-XH-A_1x07_P2.50mm_Horizontal; MPN S7B-XH-A(LF)(SN); LCSC Part C157916
J7: Raspberry Control Signals; JST_XH_S7B-XH-A_1x07_P2.50mm_Horizontal; MPN S7B-XH-A(LF)(SN); LCSC Part C157916
J8: WD_F; TerminalBlock_Phoenix_PT-1,5-2-5.0-H_1x02_P5.00mm_Horizontal; MPN 1935161; LCSC Part C3819953
J9: GPIO; PinSocket_2x20_P2.54mm_Vertical; MPN SSQ-120-03-T-D; LCSC C6235776
R13, R14: 470; R_0603_1608Metric; LCSC C23179
R18, R19: 5.1k; R_0603_1608Metric; LCSC C17414
U1, U2, U3: MSK12C02G25-B; SW-SMD_MSK12C02G25-B; MPN MSK12C02G25-B; LCSC Part C22435663
U4: IM03GR; RELAY-SMD_IMXXGR; MPN IM03GR; LCSC Part C2153100

Connections:
+3.3V: J4.1, J5.1, J6.1, J9.1, J9.17, R13.2, U1.3, U2.3, U3.3; also elsewhere on the board
+5V: J1.1, J9.2, J9.4, R18.1, R19.1; also elsewhere on the board
/+12V: J7.1; also elsewhere on the board
/B_GREEN: J9.15; also elsewhere on the board
/B_RED: J9.29; also elsewhere on the board
/B_YELLOW: J9.28; also elsewhere on the board
/CE0: J4.2, J9.37
/CE1: J5.2, J9.33
/CE2: J6.2, J9.36
/CLK: J4.3, J5.3, J6.3, J9.40
/D_CLK: J9.23
/D_LCD_CS: J9.24
/D_LCD_RS: J9.18
/D_MISO: J9.21
/D_MOSI: J9.19
/D_RST: J9.22
/D_TP_CS: J9.26
/D_TP_IRQ: J9.11
/GPIO_WD: J9.13; also elsewhere on the board
/MISO: J4.5, J5.5, J6.5, J9.35
/MOSI: J4.4, J5.4, J6.4, J9.38
/MPPT: J2.2, J9.10
/PS: J3.2, J9.8
/RST: J4.6, J5.6, J6.6, J9.32
/SLCU_BG: J7.7; also elsewhere on the board
/SLCU_BR: J7.3; also elsewhere on the board
/SLCU_BY: J7.5; also elsewhere on the board
/SLCU_SG: J7.6; also elsewhere on the board
/SLCU_SR: J7.2; also elsewhere on the board
/SLCU_SY: J7.4; also elsewhere on the board
/SW_CHRG_1: J9.3, U1.2
/SW_CHRG_2: J9.5, U2.2
/SW_CHRG_3: J9.7, U3.2
/S_GREEN: J9.16; also elsewhere on the board
/S_RED: J9.31; also elsewhere on the board
/S_YELLOW: J9.27; also elsewhere on the board
/WD_EN: J9.12; also elsewhere on the board
/Watchdog/WD_FAULT_N: D1.2 (A), U4.8; also elsewhere on the board
/Watchdog/WD_FAULT_P: D1.1 (K), U4.1; also elsewhere on the board
GND: D6.1 (K), D7.1 (K), J1.2, J2.1, J3.1, J4.7, J5.7, J6.7, J9.6, J9.9, J9.14, J9.20, J9.25, J9.30, J9.34, J9.39, U1.1, U2.1, U3.1; also elsewhere on the board
unnamed: D6.2 (A), R14.1
unnamed: D7.2 (A), R18.2, R19.2
unnamed: J8.1, U4.3
unnamed: J8.2, U4.6
unnamed: R13.1, R14.2
unnamed: U4.4, U4.5

Notes on the sheet:
Raspberry PI Pins
(D_LCD_EN)
Additional pin functions: https://pinout.xyz/
SLCU Signal Driver
RFID Connectors
WD Shütz Control
Pin header Pin for WD_EN needs to be cut of so that D_LCD_EN stays floating
Power Selector Switch
Watch Dog Circuit
Power LEDs
Charger Switches
Power IN
coil: 140mW @ 5V (@{format(0.14/5 * 1000, 3)}mA)
D_* annotates Display hat pins

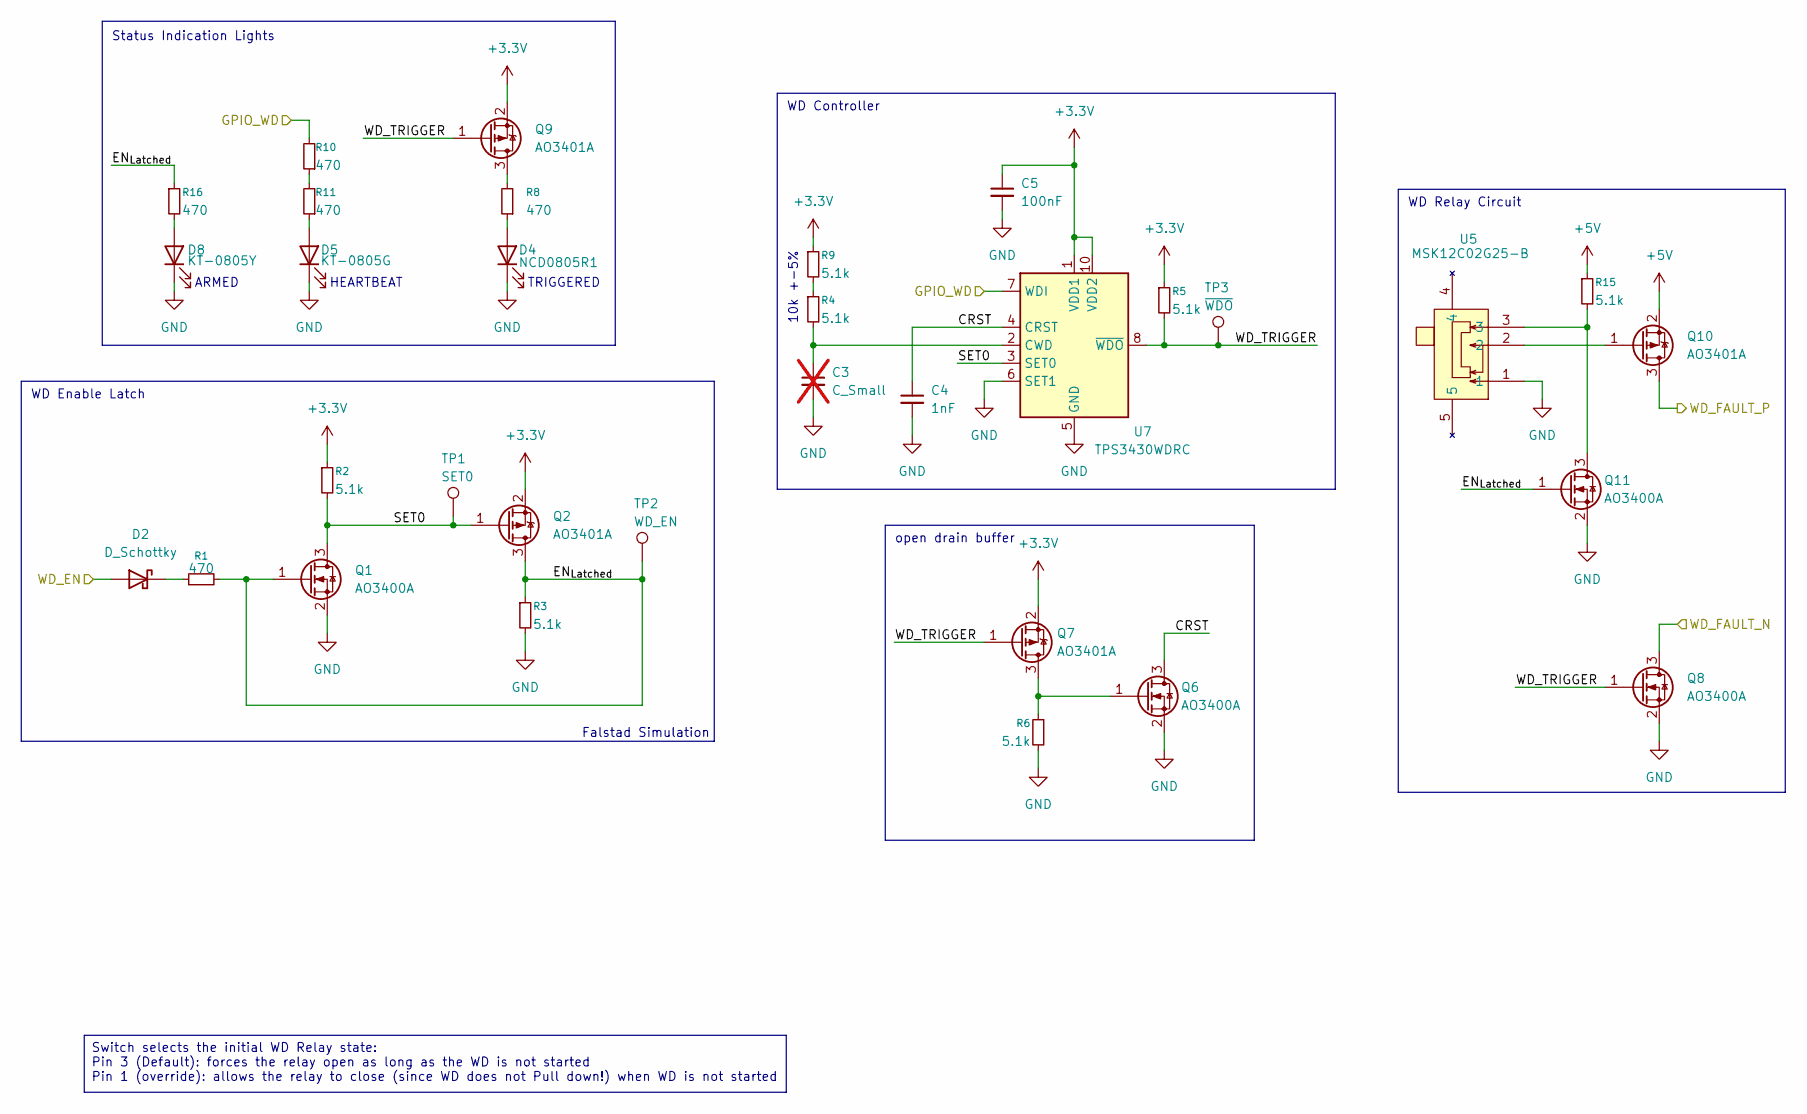
[picture p27: schematic watchdog.kicad_sch, Raspbery Pi HAT]

Parts:
C3: C_Small; C_0805_2012Metric_Pad1.18x1.45mm_HandSolder; not fitted
C4: 1nF; C_0603_1608Metric
C5: 100nF; C_0603_1608Metric; LCSC Part C14663
D2: D_Schottky; D_SOD-323
D4: NCD0805R1; LED_0805_2012Metric; MPN NCD0805R1; LCSC Part C84256
D5: KT-0805G; LED_0805_2012Metric; MPN KT-0805G; LCSC Part C2297
D8: KT-0805Y; LED_0805_2012Metric; MPN KT-0805Y; LCSC Part C2296
Q1, Q6, Q8, Q11: AO3400A; SOT-23; MPN AO3400A; LCSC Part C15127
Q2, Q7, Q9, Q10: AO3401A; SOT-23; MPN AO3401A; LCSC Part C15127
R1, R8, R10, R11, R16: 470; R_0603_1608Metric; LCSC C23179
R2, R3, R4, R5, R6, R9, R15: 5.1k; R_0603_1608Metric; LCSC C17414
TP1: SET0; TestPoint_Pad_D1.0mm
TP2: WD_EN; TestPoint_Pad_D1.0mm
TP3: ~{WDO}; TestPoint_Pad_D1.0mm
U5: MSK12C02G25-B; SW-SMD_MSK12C02G25-B; MPN MSK12C02G25-B; LCSC Part C22435663
U7: TPS3430WDRC; VSON-10-1EP_3x3mm_P0.5mm_EP1.65x2.4mm

Connections:
+3.3V: C5.1, Q2.2 (S), Q7.2 (S), Q9.2 (S), R2.1, R5.1, R9.1, U7.1 (VDD1), U7.10 (VDD2); also elsewhere on the board
+5V: Q10.2 (S), R15.1; also elsewhere on the board
/GPIO_WD: R10.2, U7.7 (WDI); also elsewhere on the board
/WD_EN: D2.2 (A); also elsewhere on the board
/Watchdog/CRST: C4.1, Q6.3 (D), U7.4 (CRST)
/Watchdog/EN_{Latched}: Q1.1 (G), Q2.3 (D), Q11.1 (G), R1.2, R3.1, R16.1, TP2.1 (1_1)
/Watchdog/SET0: Q1.3 (D), Q2.1 (G), R2.2, TP1.1 (1_1), U7.3 (SET0)
/Watchdog/WD_FAULT_N: Q8.3 (D); also elsewhere on the board
/Watchdog/WD_FAULT_P: Q10.3 (D); also elsewhere on the board
/Watchdog/WD_TRIGGER: Q7.1 (G), Q8.1 (G), Q9.1 (G), R5.2, TP3.1 (1_1), U7.8 (~WDO)
GND: C3.2, C4.2, C5.2, D4.1 (K), D5.1 (K), D8.1 (K), Q1.2 (S), Q6.2 (S), Q8.2 (S), Q11.2 (S), R3.2, R6.2, U5.1, U7.5 (GND), U7.6 (SET1), U7.11 (GND); also elsewhere on the board
unnamed: D2.1 (K), R1.1
unnamed: D4.2 (A), R8.1
unnamed: D5.2 (A), R11.1
unnamed: D8.2 (A), R16.2
unnamed: Q6.1 (G), Q7.3 (D), R6.1
unnamed: Q9.3 (D), R8.2
unnamed: Q10.1 (G), U5.2
unnamed: Q11.3 (D), R15.2, U5.3
unnamed: R4.1, R9.2
unnamed: R10.1, R11.2
unnamed: C3.1, R4.2, U7.2 (CWD)

Notes on the sheet:
HEARTBEAT
open drain buffer
10k +-5%
Falstad Simulation
WD Enable Latch
TRIGGERED
Status Indication Lights
ARMED
WD Controller
WD Relay Circuit
Switch selects the initial WD Relay state: Pin 3 (Default): forces the relay open as long as the WD is not started Pin 1 (override): allows the relay to close (since WD does not Pull down!) when WD is not started

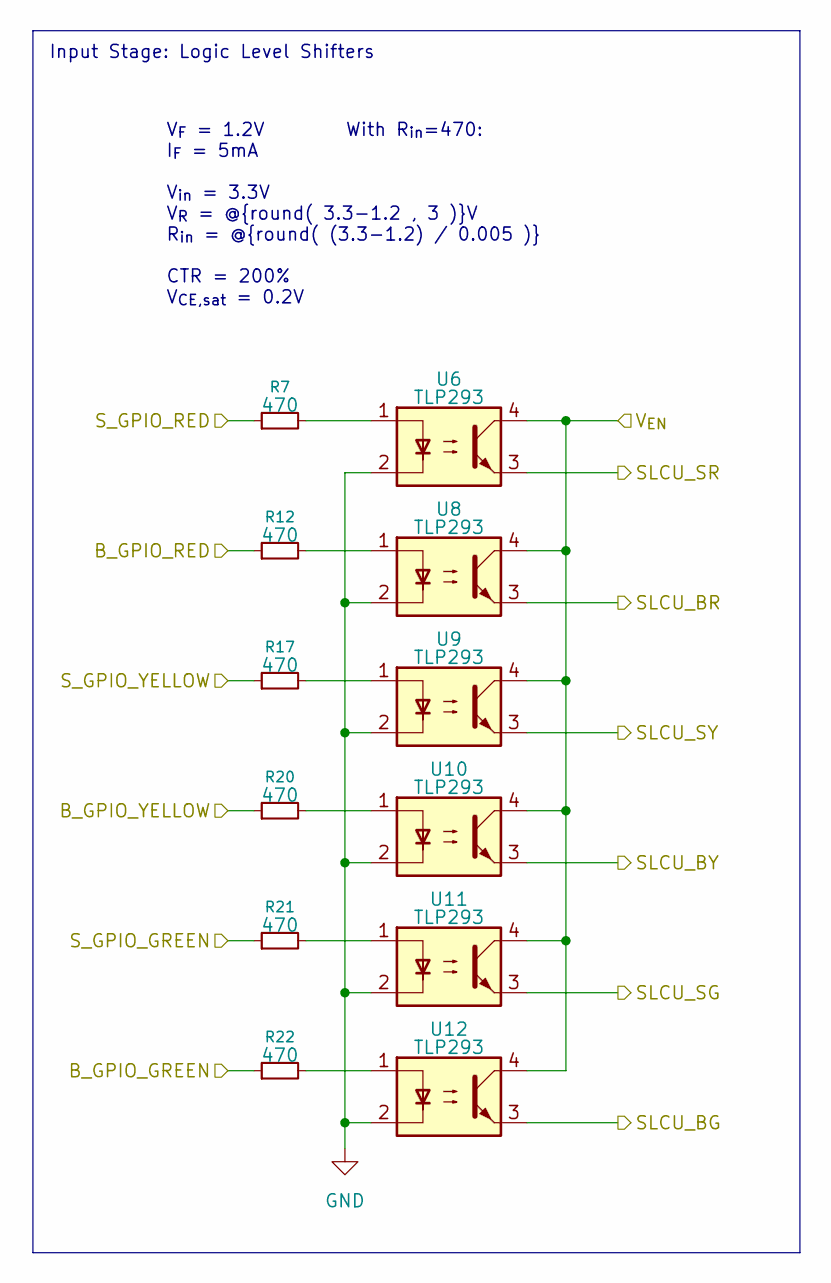
[picture p28: schematic SLCUdriver.kicad_sch, Raspbery Pi HAT]

Parts:
R7, R12, R17, R20, R21, R22: 470; R_0603_1608Metric; LCSC C23179
U6, U8, U9, U10, U11, U12: TLP293; SOIC-4_4.55x2.6mm_P1.27mm; MPN TLP293(BLL-TPL,E; LCSC C3008594

Connections:
/+12V: U6.4, U8.4, U9.4, U10.4, U11.4, U12.4; also elsewhere on the board
/B_GREEN: R22.1; also elsewhere on the board
/B_RED: R12.1; also elsewhere on the board
/B_YELLOW: R20.1; also elsewhere on the board
/SLCU_BG: U12.3; also elsewhere on the board
/SLCU_BR: U8.3; also elsewhere on the board
/SLCU_BY: U10.3; also elsewhere on the board
/SLCU_SG: U11.3; also elsewhere on the board
/SLCU_SR: U6.3; also elsewhere on the board
/SLCU_SY: U9.3; also elsewhere on the board
/S_GREEN: R21.1; also elsewhere on the board
/S_RED: R7.1; also elsewhere on the board
/S_YELLOW: R17.1; also elsewhere on the board
GND: U6.2, U8.2, U9.2, U10.2, U11.2, U12.2; also elsewhere on the board
unnamed: R7.2, U6.1
unnamed: R12.2, U8.1
unnamed: R17.2, U9.1
unnamed: R20.2, U10.1
unnamed: R21.2, U11.1
unnamed: R22.2, U12.1

Notes on the sheet:
With R_{in}=470:
V_{F} = 1.2V I_{F} = 5mA V_{in} = 3.3V V_{R} = @{round( 3.3-1.2 , 3 )}V R_{in} = @{round( (3.3-1.2) / 0.005 )} CTR = 200% V_{CE,sat} = 0.2V
Input Stage: Logic Level Shifters

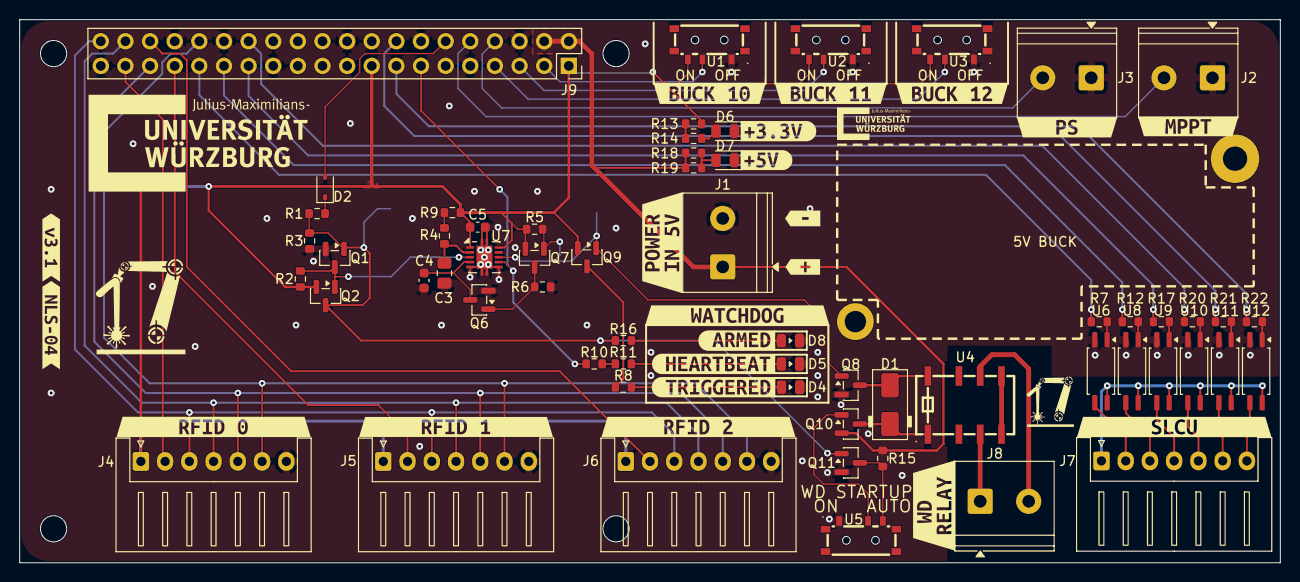
[picture p29: board charging_station/KiCad/PIHAT/PIHAT.kicad_pcb from above]

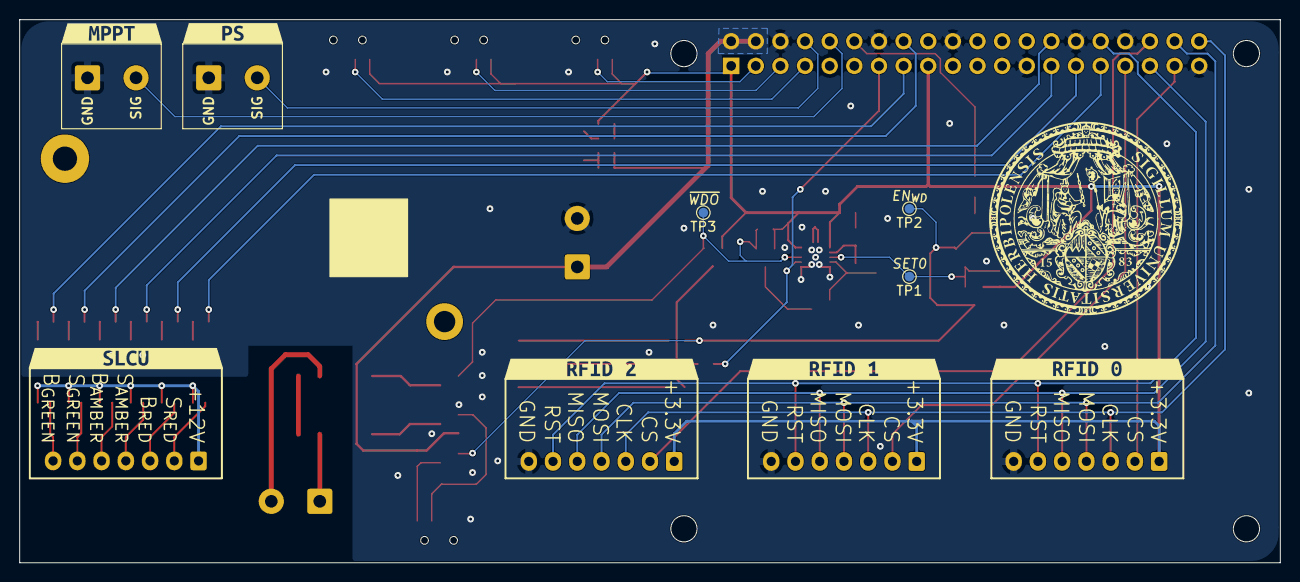
[picture p30: board charging_station/KiCad/PIHAT/PIHAT.kicad_pcb from below]

Board: 2 copper layers, 130.0 x 56.0 mm, 97 parts (13 on the bottom side), 59 nets.

Other parts of the board:
MH1, MH2, MH3, MH4: MountingHole_2.7mm_M2.5
kibuzzard-6AD53C3D: G***; kibuzzard-6AD53C3D
kibuzzard-6AD53C20, kibuzzard-6AD53C20#2: G***; kibuzzard-6AD53C20
kibuzzard-6AD53C43: G***; kibuzzard-6AD53C43
kibuzzard-6AD53C84: G***; kibuzzard-6AD53C84
kibuzzard-6AD53CF1: G***; kibuzzard-6AD53CF1
kibuzzard-6AD53D49: G***; kibuzzard-6AD53D49
kibuzzard-6AD53DF3: G***; kibuzzard-6AD53DF3
kibuzzard-6AD53E3A: G***; kibuzzard-6AD53E3A
kibuzzard-6AD53E40: G***; kibuzzard-6AD53E40
kibuzzard-6AD530C8: G***; kibuzzard-6AD530C8
kibuzzard-6AD530EA: G***; kibuzzard-6AD530EA
kibuzzard-6AD537E7: G***; kibuzzard-6AD537E7
kibuzzard-6AD540AE: G***; kibuzzard-6AD540AE
kibuzzard-6AD541D1: G***; kibuzzard-6AD541D1
kibuzzard-6AD543B1: G***; kibuzzard-6AD543B1
kibuzzard-6AD543B7: G***; kibuzzard-6AD543B7
kibuzzard-6AD554A5: G***; kibuzzard-6AD554A5
kibuzzard-6AD5310E: G***; kibuzzard-6AD5310E
kibuzzard-6AD5403C: G***; kibuzzard-6AD5403C
kibuzzard-6AD54089: G***; kibuzzard-6AD54089
kibuzzard-6AF5E61E: G***; kibuzzard-6AF5E61E
kibuzzard-6AF5E623: G***; kibuzzard-6AF5E623
kibuzzard-6AF5EA3F: G***; kibuzzard-6AF5EA3F
kibuzzard-6AF5F1CD: G***; kibuzzard-6AF5F1CD
kibuzzard-6AF5F1D2: G***; kibuzzard-6AF5F1D2
kibuzzard-6AF35593: G***; kibuzzard-6AF35593
