JMUWRobotics/AMADEE-27/charging_station/KiCad/PIHAT/_restore_backup_2026-10-15T17-27-58-269/PIHAT.kicad_pcb

## KiCad design charging_station/KiCad/PIHAT/_restore_backup_2026-10-15T17-27-58-269/PIHAT.kicad_pcb (2026-10-17)

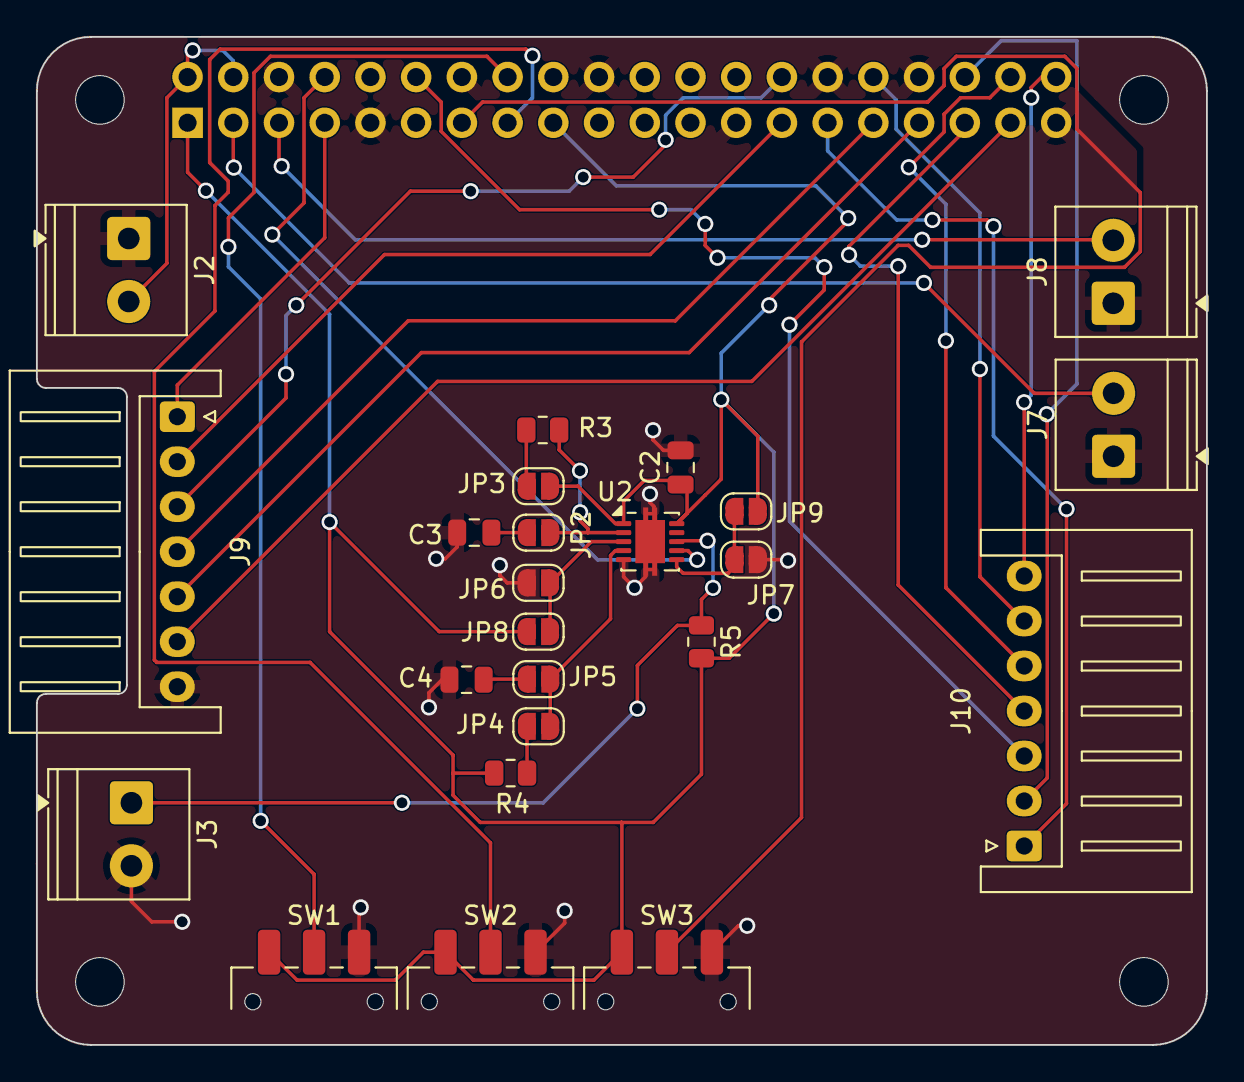
[picture p31: board charging_station/KiCad/PIHAT/_restore_backup_2026-10-15T17-27-58-269/… from above]

Board: 2 copper layers, 65.0 x 56.0 mm, 29 parts (1 on the bottom side), 31 nets.

Parts:
C2: 100nf; C_0805_2012Metric
C3, C4: C; C_0805_2012Metric
J1: GPIO; PinSocket_2x20_P2.54mm_Vertical
J2: 5v(Vin); TerminalBlock_Phoenix_PT-1,5-2-3.5-H_1x02_P3.50mm_Horizontal
J3: WD_F; TerminalBlock_Phoenix_PT-1,5-2-3.5-H_1x02_P3.50mm_Horizontal
J7: MPPT; TerminalBlock_Phoenix_PT-1,5-2-3.5-H_1x02_P3.50mm_Horizontal
J8: PS; TerminalBlock_Phoenix_PT-1,5-2-3.5-H_1x02_P3.50mm_Horizontal
J9: Stack light; JST_XH_S7B-XH-A_1x07_P2.50mm_Horizontal
J10: RFID; JST_XH_S7B-XH-A_1x07_P2.50mm_Horizontal
JP2, JP3, JP4, JP5, JP6, JP7, JP8, JP9: SolderJumper_2_Open; SolderJumper-2_P1.3mm_Open_RoundedPad1.0x1.5mm
MH1, MH2, MH3, MH4: MountingHole_2.7mm_M2.5
R3, R5: 10k; R_0805_2012Metric
R4: R; R_0805_2012Metric
SW1, SW2, SW3: Sw_1; SW_SPDT_CK_JS102011SAQN
U2: TPS3430WDRC; VSON-10-1EP_3x3mm_P0.5mm_EP1.65x2.4mm

Connections:
/Raspi5/3v3: C2.1, J1.1, J1.17, JP3.1 (A), JP8.2 (B), JP9.2 (B), R4.1, R5.2, SW1.1, SW2.1, SW3.1, U2.1 (VDD1), U2.10 (VDD2)
/Raspi5/5v: J1.2, J1.4, J2.2
/Raspi5/GPIO0/R_MO: J1.27, J9.2
/Raspi5/GPIO1/Y_ST: J1.28, J9.3
/Raspi5/GPIO2/MPPT: J1.3, J7.2
/Raspi5/GPIO3/PS: J1.5, J8.2
/Raspi5/GPIO4/R_ST: J1.7, J9.1
/Raspi5/GPIO5/CE1: J1.29, J10.1
/Raspi5/GPIO6/Y_MO: J1.31, J9.4
/Raspi5/GPIO12/RST: J1.32, J10.6
/Raspi5/GPIO13/G_ST: J1.33, J9.5
/Raspi5/GPIO14/GPIO_WD: J1.8, U2.7 (WDI)
/Raspi5/GPIO16/CE2: J1.36, J10.2
/Raspi5/GPIO18/CE0: J1.12, J10.3
/Raspi5/GPIO19/MISO: J1.35, J10.4
/Raspi5/GPIO20/MOSI: J1.38, J10.5
/Raspi5/GPIO21/CLK: J1.40, J10.7
/Raspi5/GPIO22: J1.15, SW2.2 (3)
/Raspi5/GPIO23: J1.16, SW1.2 (3)
/Raspi5/GPIO26/G_MO: J1.37, J9.6
/Raspi5/GPIO27: J1.13, SW3.2 (3)
/Watchdog/WD_FAULT: J3.1, R5.1, U2.8 (~WDO)
GND: C2.2, C3.1, C4.1, J1.6, J1.9, J1.14, J1.20, J1.25, J1.30, J1.34, J1.39, J2.1, J3.2, J7.1, J8.1, J9.7, JP6.1 (A), JP7.1 (A), SW1.3 (4), SW2.3 (4), SW3.3 (4), U2.5 (GND), U2.11 (GND)
unnamed: C3.2, JP2.1 (A)
unnamed: JP2.2 (B), R3.1, U2.2 (CWD)
unnamed: JP3.2 (B), R3.2
unnamed: JP4.1 (A), JP5.2 (B), U2.4 (CRST)
unnamed: JP4.2 (B), R4.2
unnamed: C4.2, JP5.1 (A)
unnamed: JP6.2 (B), JP8.1 (A), U2.3 (SET0)
unnamed: JP7.2 (B), JP9.1 (A), U2.6 (SET1)
