JMUWRobotics/AMADEE-27/charging_station/KiCad/SLCU/SLCU.kicad_pcb

## KiCad design charging_station/KiCad/SLCU/SLCU.kicad_pcb (2026-10-16)

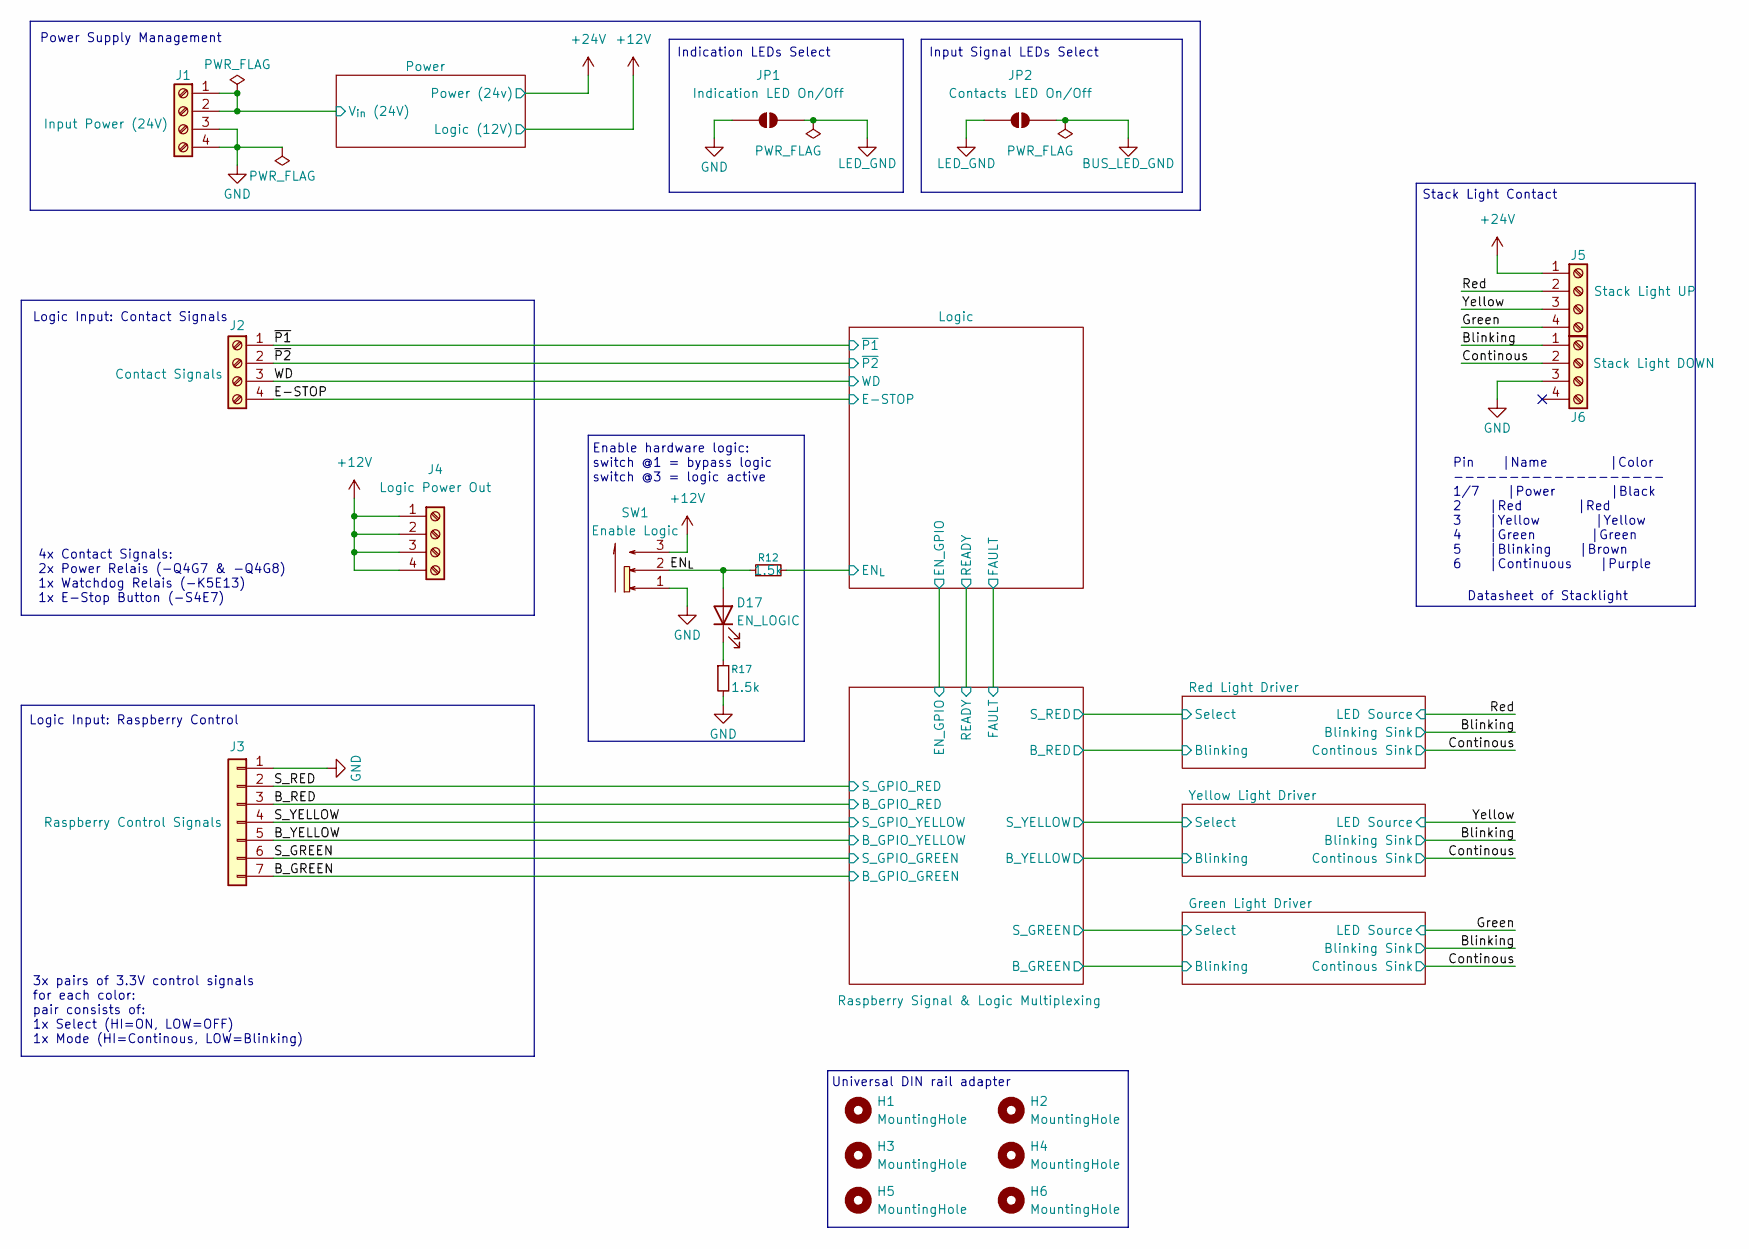
[picture p32: schematic SLCU.kicad_sch, SLCU (Stack Light Control Unit)]

Parts:
D17: EN_LOGIC; LED_0805_2012Metric_Pad1.15x1.40mm_HandSolder
H1, H2, H3, H4, H5, H6: MountingHole; MountingHole_3.2mm_M3
J1: Input Power (24V); TerminalBlock_Phoenix_MKDS-1,5-4_1x04_P5.00mm_Horizontal; MPN 1935187; LCSC Part C3817931
J2: Contact Signals; TerminalBlock_Phoenix_MKDS-1,5-4_1x04_P5.00mm_Horizontal; MPN 1935187; LCSC Part C3817931
J3: Raspberry Control Signals; JST_XH_S7B-XH-A_1x07_P2.50mm_Horizontal; MPN S7B-XH-A(LF)(SN); LCSC Part C157916
J4: Logic Power Out; TerminalBlock_Phoenix_MKDS-1,5-4_1x04_P5.00mm_Horizontal; MPN 1935187; LCSC Part C3817931
J5: Stack Light UP; TerminalBlock_Phoenix_MKDS-1,5-4_1x04_P5.00mm_Horizontal; MPN 1935187; LCSC Part C3817931
J6: Stack Light DOWN; TerminalBlock_Phoenix_MKDS-1,5-4_1x04_P5.00mm_Horizontal; MPN 1935187; LCSC Part C3817931
JP1: Indication LED On/Off; SolderJumper-2_P1.3mm_Open_RoundedPad1.0x1.5mm
JP2: Contacts LED On/Off; SolderJumper-2_P1.3mm_Open_RoundedPad1.0x1.5mm
R12, R17: 1.5k; R_0805_2012Metric_Pad1.20x1.40mm_HandSolder
SW1: Enable Logic; SW-SMD_SHOUHAN_MST-22D18G23J_C2875122; MPN MST-22D18G2 3J; LCSC Part C2875122

Connections:
+12V: J4.1, J4.2, J4.3, J4.4, SW1.3; also elsewhere on the board
+24V: J5.1; also elsewhere on the board
/B_GREEN: J3.7; also elsewhere on the board
/B_RED: J3.3; also elsewhere on the board
/B_YELLOW: J3.5; also elsewhere on the board
/Blinking: J6.1; also elsewhere on the board
/Continous: J6.2; also elsewhere on the board
/E-STOP: J2.4; also elsewhere on the board
/EN_{L}: D17.2 (A), R12.1, SW1.2
/Green: J5.4; also elsewhere on the board
/Logic/EN_{L}: R12.2; also elsewhere on the board
/Power/V_{in} (24V): J1.1, J1.2; also elsewhere on the board
/Red: J5.2; also elsewhere on the board
/S_GREEN: J3.6; also elsewhere on the board
/S_RED: J3.2; also elsewhere on the board
/S_YELLOW: J3.4; also elsewhere on the board
/WD: J2.3; also elsewhere on the board
/Yellow: J5.3; also elsewhere on the board
/~P1: J2.1; also elsewhere on the board
/~P2: J2.2; also elsewhere on the board
BUS_LED_GND: JP2.2 (B); also elsewhere on the board
GND: J1.3, J1.4, J3.1, J6.3, JP1.1 (A), R17.2, SW1.1; also elsewhere on the board
LED_GND: JP1.2 (B), JP2.1 (A); also elsewhere on the board
unnamed: D17.1 (K), R17.1

Notes on the sheet:
Input Signal LEDs Select
Enable hardware logic: switch @1 = bypass logic switch @3 = logic active
Logic Input: Raspberry Control
Power Supply Management
Indication LEDs Select
Datasheet of Stacklight
Pin |Name |Color ------------------- 1/7 |Power |Black 2 |Red |Red 3 |Yellow |Yellow 4 |Green |Green 5 |Blinking |Brown 6 |Continuous |Purple
Logic Input: Contact Signals
3x pairs of 3.3V control signals for each color: pair consists of: 1x Select (HI=ON, LOW=OFF) 1x Mode (HI=Continous, LOW=Blinking)
Stack Light Contact
Universal DIN rail adapter
4x Contact Signals: 2x Power Relais (-Q4G7 & -Q4G8) 1x Watchdog Relais (-K5E13) 1x E-Stop Button (-S4E7)

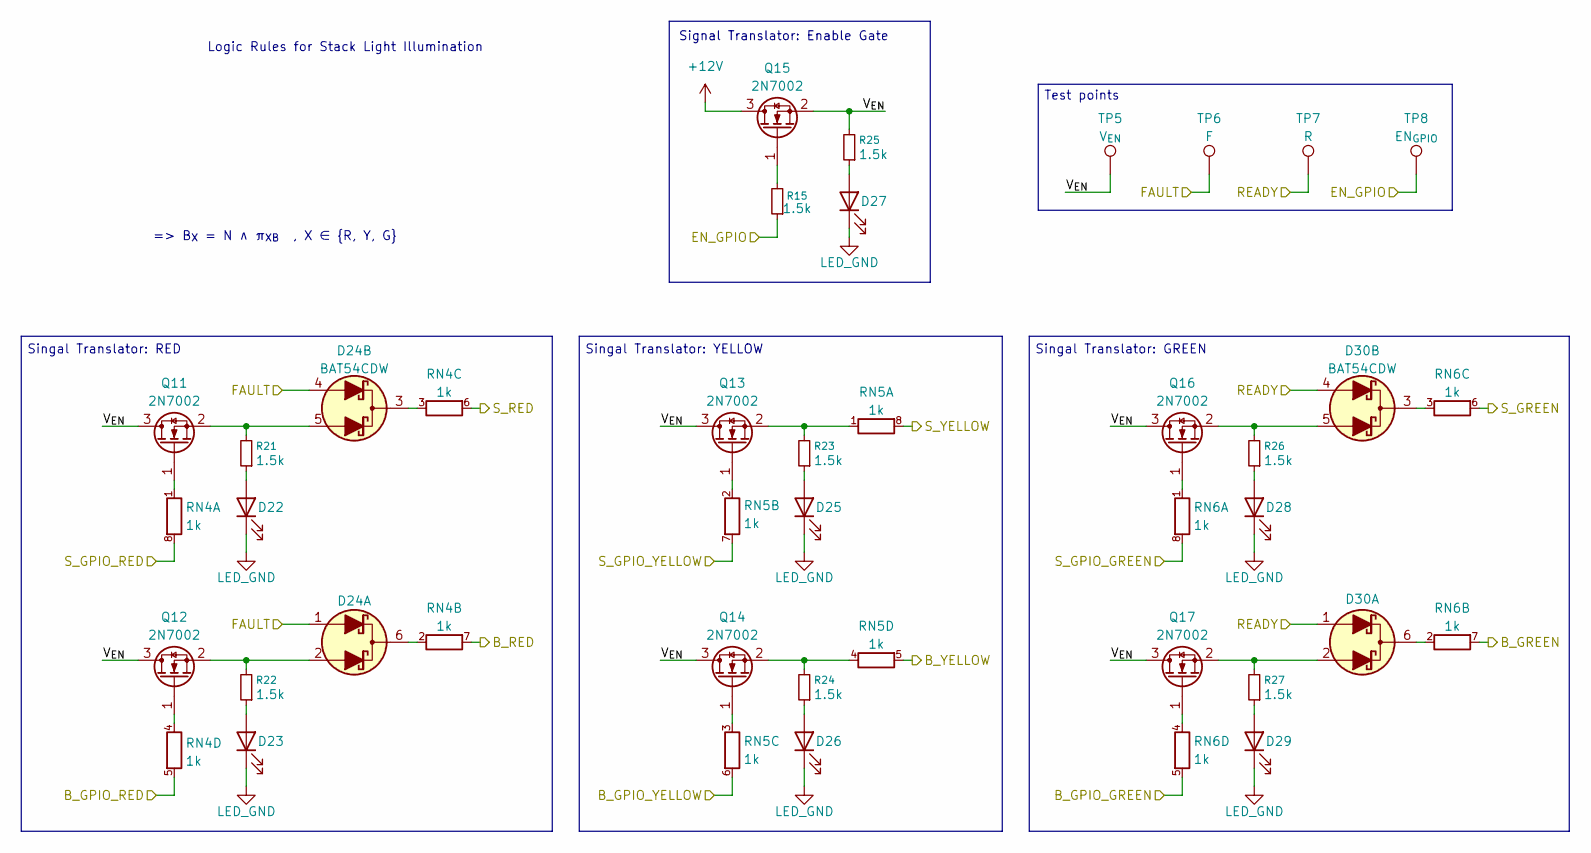
[picture p33: schematic GPIO_MUX.kicad_sch, SLCU (Stack Light Control Unit)]

Parts:
D22, D23, D25, D26, D27, D28, D29: LED; LED_0805_2012Metric_Pad1.15x1.40mm_HandSolder
D24, D30: BAT54CDW; SOT-363_SC-70-6
Q11, Q12, Q13, Q14, Q15, Q16, Q17: 2N7002; SOT-323_SC-70
R15, R21, R22, R23, R24, R25, R26, R27: 1.5k; R_0805_2012Metric_Pad1.20x1.40mm_HandSolder
RN4, RN5, RN6: 1k; RES-ARRAY-SMD_0603-8P-L3.2-W1.6-BL; MPN 4D03WGJ0102T5E; LCSC Part C20197
TP5: V_{EN}; TestPoint_Pad_D1.0mm
TP6: F; TestPoint_Pad_D1.0mm
TP7: R; TestPoint_Pad_D1.0mm
TP8: EN_{GPIO}; TestPoint_Pad_D1.0mm

Connections:
+12V: Q15.3 (D); also elsewhere on the board
/B_GREEN: RN6.5 (R4.2); also elsewhere on the board
/B_RED: RN4.5 (R4.2); also elsewhere on the board
/B_YELLOW: RN5.6 (R3.2); also elsewhere on the board
/Green Light Driver/Blinking: RN6.7 (R2.2); also elsewhere on the board
/Green Light Driver/Select: RN6.6 (R3.2); also elsewhere on the board
/Logic/EN_GPIO: R15.1, TP8.1 (1_1); also elsewhere on the board
/Logic/FAULT: D24.1 (A1), D24.4 (A2), TP6.1 (1_1); also elsewhere on the board
/Logic/READY: D30.1 (A1), D30.4 (A2), TP7.1 (1_1); also elsewhere on the board
/Raspberry Signal & Logic Multiplexing/B_RED: RN4.7 (R2.2); also elsewhere on the board
/Raspberry Signal & Logic Multiplexing/B_YELLOW: RN5.5 (R4.2); also elsewhere on the board
/Raspberry Signal & Logic Multiplexing/S_RED: RN4.6 (R3.2); also elsewhere on the board
/Raspberry Signal & Logic Multiplexing/S_YELLOW: RN5.8 (R1.2); also elsewhere on the board
/Raspberry Signal & Logic Multiplexing/V_{EN}: Q11.3 (D), Q12.3 (D), Q13.3 (D), Q14.3 (D), Q15.2 (S), Q16.3 (D), Q17.3 (D), R25.2, TP5.1 (1_1)
/S_GREEN: RN6.8 (R1.2); also elsewhere on the board
/S_RED: RN4.8 (R1.2); also elsewhere on the board
/S_YELLOW: RN5.7 (R2.2); also elsewhere on the board
LED_GND: D22.1 (K), D23.1 (K), D25.1 (K), D26.1 (K), D27.1 (K), D28.1 (K), D29.1 (K); also elsewhere on the board
unnamed: D22.2 (A), R21.1
unnamed: D23.2 (A), R22.1
unnamed: D24.6 (K1), RN4.2 (R2.1)
unnamed: D24.3 (K2), RN4.3 (R3.1)
unnamed: D25.2 (A), R23.1
unnamed: D26.2 (A), R24.1
unnamed: D27.2 (A), R25.1
unnamed: D28.2 (A), R26.1
unnamed: D29.2 (A), R27.1
unnamed: D30.6 (K1), RN6.2 (R2.1)
unnamed: D30.3 (K2), RN6.3 (R3.1)
unnamed: Q11.1 (G), RN4.1 (R1.1)
unnamed: D24.5 (A2), Q11.2 (S), R21.2
unnamed: Q12.1 (G), RN4.4 (R4.1)
unnamed: D24.2 (A1), Q12.2 (S), R22.2
unnamed: Q13.1 (G), RN5.2 (R2.1)
unnamed: Q13.2 (S), R23.2, RN5.1 (R1.1)
unnamed: Q14.1 (G), RN5.3 (R3.1)
unnamed: Q14.2 (S), R24.2, RN5.4 (R4.1)
unnamed: Q15.1 (G), R15.2
unnamed: Q16.1 (G), RN6.1 (R1.1)
unnamed: D30.5 (A2), Q16.2 (S), R26.2
unnamed: Q17.1 (G), RN6.4 (R4.1)
unnamed: D30.2 (A1), Q17.2 (S), R27.2

Notes on the sheet:
Singal Translator: GREEN
Signal Translator: Enable Gate
Singal Translator: YELLOW
=> B_{X} = N ∧ π_{XB} , X ∈ {R, Y, G}
Test points
Singal Translator: RED
Logic Rules for Stack Light Illumination
