JMUWRobotics/AMADEE-27/charging_station/KiCad/SLCU/SLCU.kicad_pcb

## KiCad design charging_station/KiCad/SLCU/SLCU.kicad_pcb (continued)

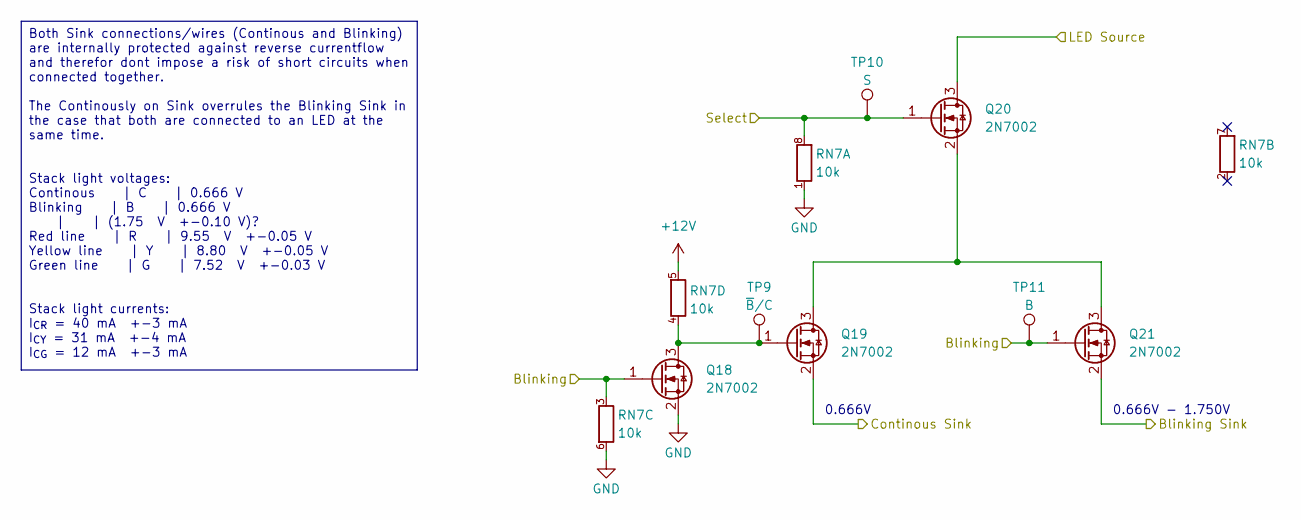
[picture p34: schematic LED_controller.kicad_sch, SLCU (Stack Light Control Unit)]

Parts:
Q18, Q19, Q20, Q21: 2N7002; SOT-323_SC-70
RN7: 10k; RES-ARRAY-SMD_0603-8P-L3.2-W1.6-BL; MPN 4D03WGJ0103T5E; LCSC Part C29718
TP9: ~{B}/C; TestPoint_Pad_D1.0mm
TP10: S; TestPoint_Pad_D1.0mm
TP11: B; TestPoint_Pad_D1.0mm

Connections:
+12V: RN7.5 (R4.2); also elsewhere on the board
/Blinking: Q21.2 (S); also elsewhere on the board
/Continous: Q19.2 (S); also elsewhere on the board
/Raspberry Signal & Logic Multiplexing/B_RED: Q18.1 (G), Q21.1 (G), RN7.3 (R3.1), TP11.1 (1_1); also elsewhere on the board
/Raspberry Signal & Logic Multiplexing/S_RED: Q20.1 (G), RN7.8 (R1.2), TP10.1 (1_1); also elsewhere on the board
/Red: Q20.3 (D); also elsewhere on the board
GND: Q18.2 (S), RN7.1 (R1.1), RN7.6 (R3.2); also elsewhere on the board
unnamed: Q18.3 (D), Q19.1 (G), RN7.4 (R4.1), TP9.1 (1_1)
unnamed: Q19.3 (D), Q20.2 (S), Q21.3 (D)

Parts of its further copies:
Q22, Q23, Q24, Q25, Q26, Q27, Q28, Q29: 2N7002; SOT-323_SC-70
RN8, RN9: 10k; RES-ARRAY-SMD_0603-8P-L3.2-W1.6-BL; MPN 4D03WGJ0103T5E; LCSC Part C29718
TP12, TP15: ~{B}/C; TestPoint_Pad_D1.0mm
TP13, TP16: S; TestPoint_Pad_D1.0mm
TP14, TP17: B; TestPoint_Pad_D1.0mm

Connections of its further copies:
+12V: RN8.5 (R4.2), RN9.5 (R4.2); also elsewhere on the board
/Blinking: Q25.2 (S), Q29.2 (S); also elsewhere on the board
/Continous: Q23.2 (S), Q27.2 (S); also elsewhere on the board
/Green: Q28.3 (D); also elsewhere on the board
/Green Light Driver/Blinking: Q26.1 (G), Q29.1 (G), RN9.3 (R3.1), TP17.1 (1_1); also elsewhere on the board
/Green Light Driver/Select: Q28.1 (G), RN9.8 (R1.2), TP16.1 (1_1); also elsewhere on the board
/Raspberry Signal & Logic Multiplexing/B_YELLOW: Q22.1 (G), Q25.1 (G), RN8.3 (R3.1), TP14.1 (1_1); also elsewhere on the board
/Raspberry Signal & Logic Multiplexing/S_YELLOW: Q24.1 (G), RN8.8 (R1.2), TP13.1 (1_1); also elsewhere on the board
/Yellow: Q24.3 (D); also elsewhere on the board
GND: Q22.2 (S), Q26.2 (S), RN8.1 (R1.1), RN8.6 (R3.2), RN9.1 (R1.1), RN9.6 (R3.2); also elsewhere on the board
unnamed: Q22.3 (D), Q23.1 (G), RN8.4 (R4.1), TP12.1 (1_1)
unnamed: Q23.3 (D), Q24.2 (S), Q25.3 (D)
unnamed: Q26.3 (D), Q27.1 (G), RN9.4 (R4.1), TP15.1 (1_1)
unnamed: Q27.3 (D), Q28.2 (S), Q29.3 (D)

Notes on the sheet:
0.666V
0.666V - 1.750V
Both Sink connections/wires (Continous and Blinking) are internally protected against reverse currentflow and therefor dont impose a risk of short circuits when connected together. The Continously on Sink overrules the Blinking Sink in the case that both are connected to an LED at the same time. St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

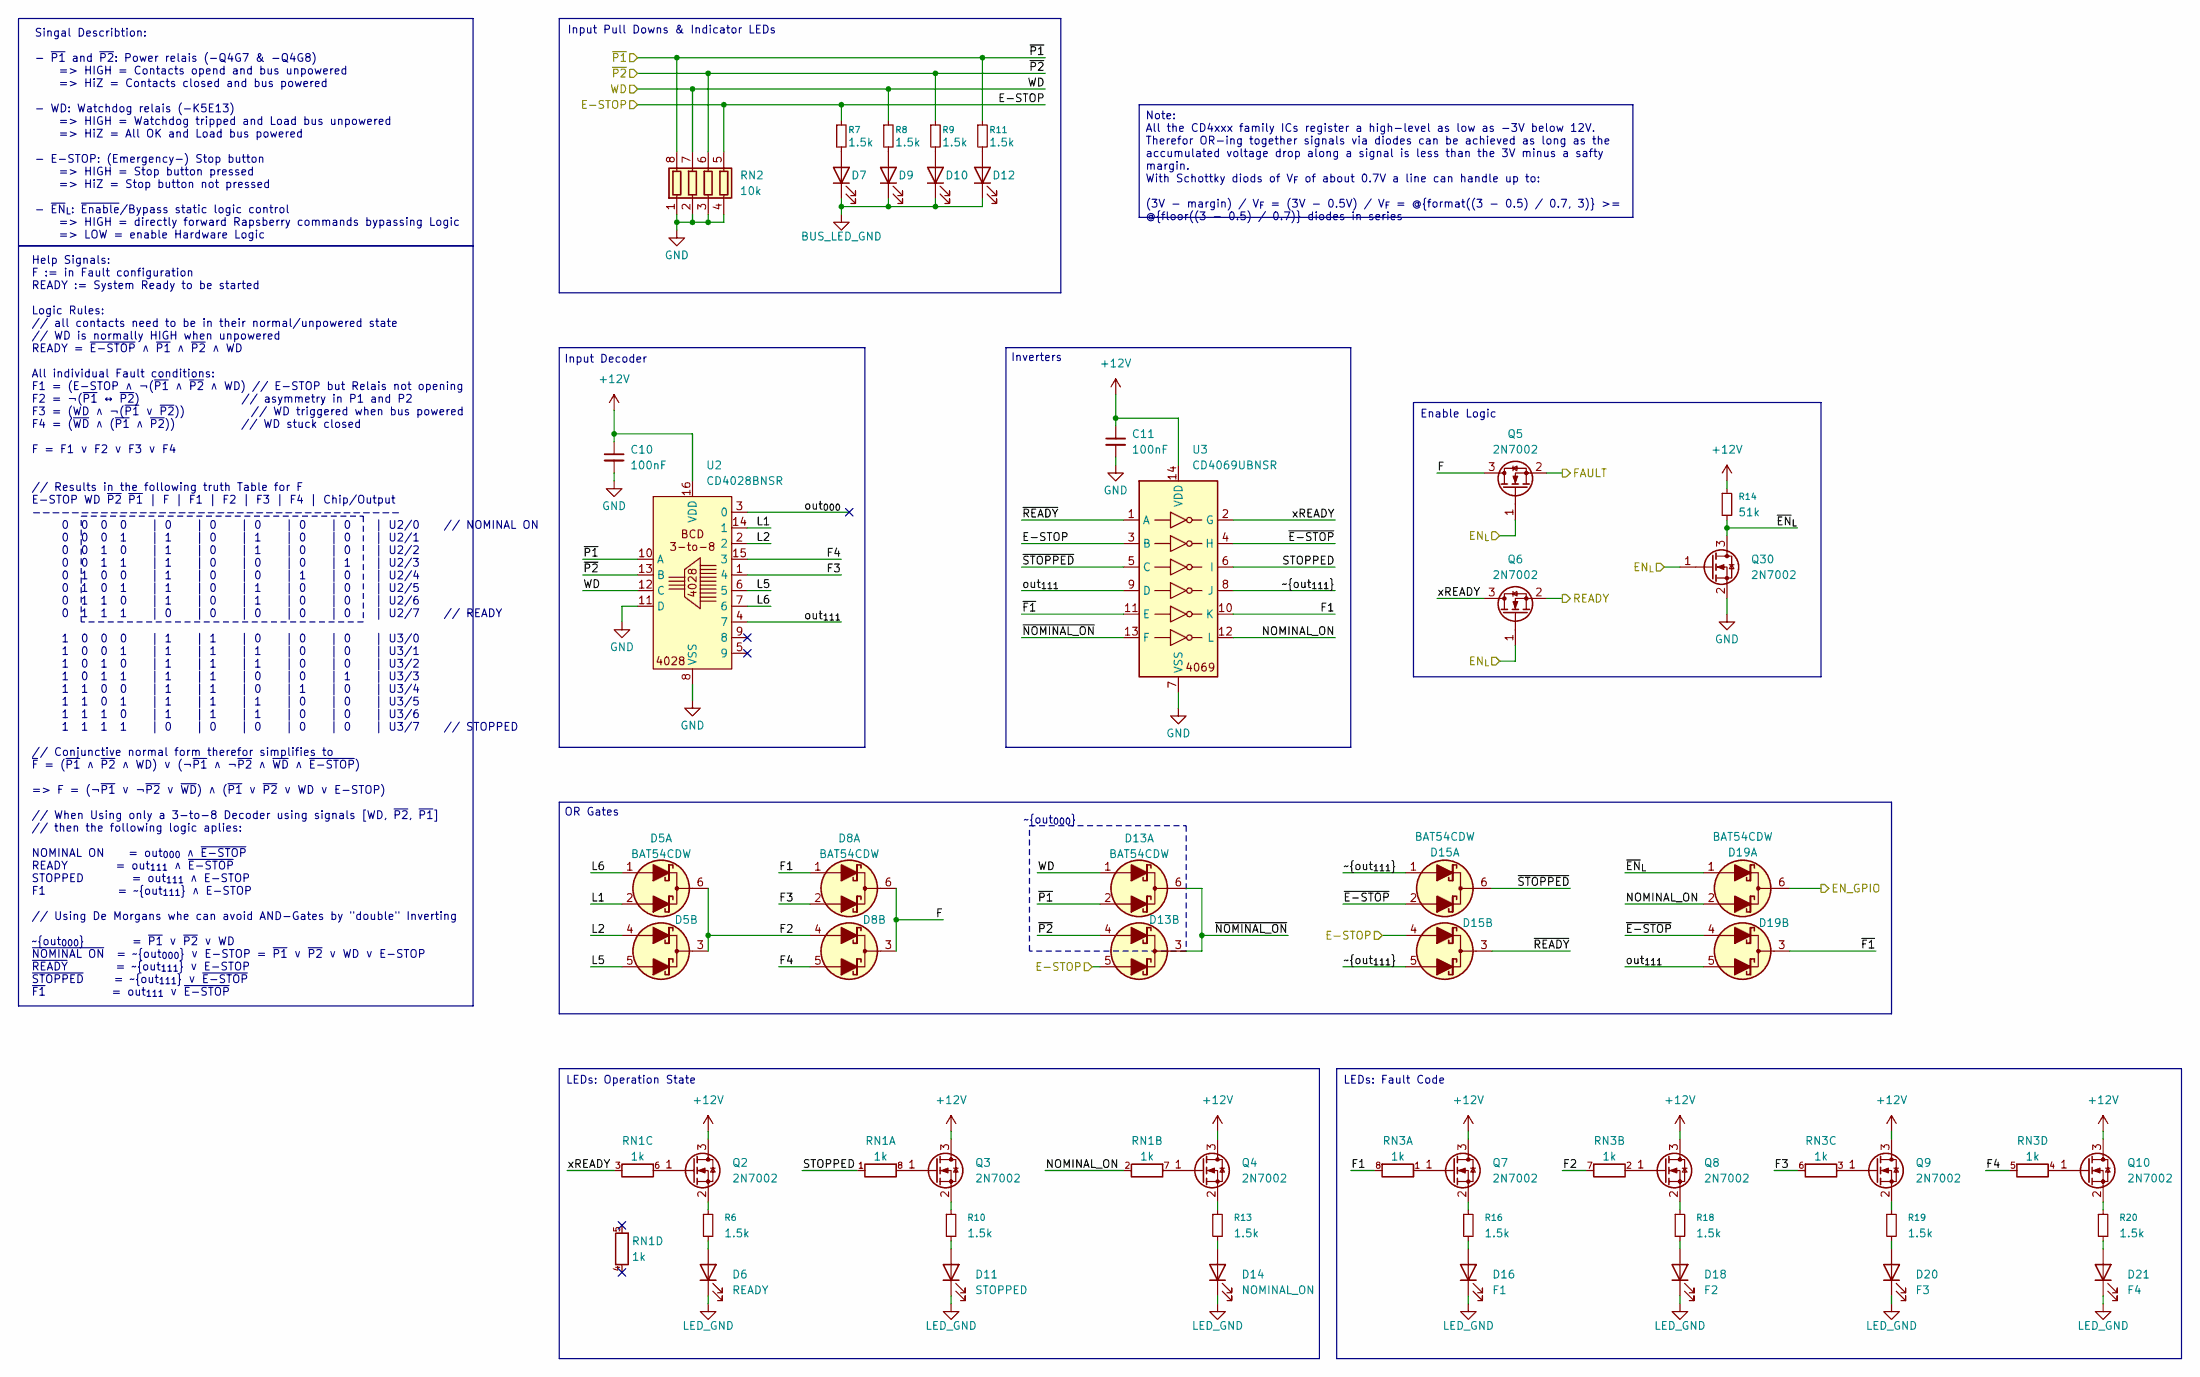
[picture p35: schematic logic.kicad_sch, SLCU (Stack Light Control Unit)]

Parts:
C10, C11: 100nF; C_0805_2012Metric_Pad1.18x1.45mm_HandSolder
D5, D8, D13, D15, D19: BAT54CDW; SOT-363_SC-70-6
D6: READY; LED_0805_2012Metric_Pad1.15x1.40mm_HandSolder
D7: E-STOP; LED_0805_2012Metric_Pad1.15x1.40mm_HandSolder
D9: WD; LED_0805_2012Metric_Pad1.15x1.40mm_HandSolder
D10: ~{P2}; LED_0805_2012Metric_Pad1.15x1.40mm_HandSolder
D11: STOPPED; LED_0805_2012Metric_Pad1.15x1.40mm_HandSolder
D12: ~{P1}; LED_0805_2012Metric_Pad1.15x1.40mm_HandSolder
D14: NOMINAL_ON; LED_0805_2012Metric_Pad1.15x1.40mm_HandSolder
D16: F1; LED_0805_2012Metric_Pad1.15x1.40mm_HandSolder
D18: F2; LED_0805_2012Metric_Pad1.15x1.40mm_HandSolder
D20: F3; LED_0805_2012Metric_Pad1.15x1.40mm_HandSolder
D21: F4; LED_0805_2012Metric_Pad1.15x1.40mm_HandSolder
Q2, Q3, Q4, Q5, Q6, Q7, Q8, Q9, Q10, Q30: 2N7002; SOT-323_SC-70
R6, R7, R8, R9, R10, R11, R13, R16, R18, R19, R20: 1.5k; R_0805_2012Metric_Pad1.20x1.40mm_HandSolder
R14: 51k; R_0805_2012Metric_Pad1.20x1.40mm_HandSolder
RN1, RN3: 1k; RES-ARRAY-SMD_0603-8P-L3.2-W1.6-BL; MPN 4D03WGJ0102T5E; LCSC Part C20197
RN2: 10k; RES-ARRAY-SMD_0603-8P-L3.2-W1.6-BL; MPN 4D03WGJ0103T5E; LCSC Part C29718
U2: CD4028BNSR; SOIC127P780X200-16N; MPN CD4028BNSR; LCSC Part C2869122
U3: CD4069UBNSR; SOIC127P780X200-14N; Mouser Part Number 595-CD4069UBNSR

Connections:
+12V: C10.1, C11.1, Q2.3 (D), Q3.3 (D), Q4.3 (D), Q7.3 (D), Q8.3 (D), Q9.3 (D), Q10.3 (D), R14.1, U2.16 (VDD), U3.14 (VDD); also elsewhere on the board
/E-STOP: D13.5 (A2), D15.4 (A2), R7.1, RN2.5 (R4.2), U3.3 (B); also elsewhere on the board
/Logic/EN_GPIO: D19.6 (K1); also elsewhere on the board
/Logic/EN_{L}: Q5.1 (G), Q6.1 (G), Q30.1 (G); also elsewhere on the board
/Logic/F: D8.3 (K2), D8.6 (K1), Q5.3 (D)
/Logic/F1: D8.1 (A1), RN3.8 (R1.2), U3.10 (K)
/Logic/F2: D5.3 (K2), D5.6 (K1), D8.4 (A2), RN3.7 (R2.2)
/Logic/F3: D8.2 (A1), RN3.6 (R3.2), U2.1 (4)
/Logic/F4: D8.5 (A2), RN3.5 (R4.2), U2.15 (3)
/Logic/FAULT: Q5.2 (S); also elsewhere on the board
/Logic/L1: D5.2 (A1), U2.14 (1)
/Logic/L2: D5.4 (A2), U2.2
/Logic/L5: D5.5 (A2), U2.6 (5)
/Logic/L6: D5.1 (A1), U2.7 (6)
/Logic/NOMINAL_ON: D19.2 (A1), RN1.2 (R2.1), U3.12 (L)
/Logic/READY: Q6.2 (S); also elsewhere on the board
/Logic/STOPPED: RN1.1 (R1.1), U3.6 (I)
/Logic/out_{000}: U2.3 (0)
/Logic/out_{111}: D19.5 (A2), U2.4 (7), U3.9 (D)
/Logic/xREADY: Q6.3 (D), RN1.3 (R3.1), U3.2 (G)
/Logic/~E-STOP: D15.2 (A1), D19.4 (A2), U3.4 (H)
/Logic/~EN_{L}: D19.1 (A1), Q30.3 (D), R14.2
/Logic/~F1: D19.3 (K2), U3.11 (E)
/Logic/~NOMINAL_ON: D13.3 (K2), D13.6 (K1), U3.13 (F)
/Logic/~READY: D15.3 (K2), U3.1 (A)
/Logic/~STOPPED: D15.6 (K1), U3.5 (C)
/Logic/~out_{111}: D15.1 (A1), D15.5 (A2), U3.8 (J)
/WD: D13.1 (A1), R8.1, RN2.7 (R2.2), U2.12 (C); also elsewhere on the board
/~P1: D13.2 (A1), R11.1, RN2.8 (R1.2), U2.10 (A); also elsewhere on the board
/~P2: D13.4 (A2), R9.1, RN2.6 (R3.2), U2.13 (B); also elsewhere on the board
BUS_LED_GND: D7.1 (K), D9.1 (K), D10.1 (K), D12.1 (K); also elsewhere on the board
GND: C10.2, C11.2, Q30.2 (S), RN2.1 (R1.1), RN2.2 (R2.1), RN2.3 (R3.1), RN2.4 (R4.1), U2.8 (VSS), U2.11 (D), U3.7 (VSS); also elsewhere on the board
LED_GND: D6.1 (K), D11.1 (K), D14.1 (K), D16.1 (K), D18.1 (K), D20.1 (K), D21.1 (K); also elsewhere on the board
unnamed: D6.2 (A), R6.2
unnamed: D7.2 (A), R7.2
unnamed: D9.2 (A), R8.2
unnamed: D10.2 (A), R9.2
unnamed: D11.2 (A), R10.2
unnamed: D12.2 (A), R11.2
unnamed: D14.2 (A), R13.2
unnamed: D16.2 (A), R16.2
unnamed: D18.2 (A), R18.2
unnamed: D20.2 (A), R19.2
unnamed: D21.2 (A), R20.2
unnamed: Q2.1 (G), RN1.6 (R3.2)
unnamed: Q2.2 (S), R6.1
unnamed: Q3.1 (G), RN1.8 (R1.2)
unnamed: Q3.2 (S), R10.1
unnamed: Q4.1 (G), RN1.7 (R2.2)
unnamed: Q4.2 (S), R13.1
unnamed: Q7.1 (G), RN3.1 (R1.1)
unnamed: Q7.2 (S), R16.1
unnamed: Q8.1 (G), RN3.2 (R2.1)
unnamed: Q8.2 (S), R18.1
unnamed: Q9.1 (G), RN3.3 (R3.1)
unnamed: Q9.2 (S), R19.1
unnamed: Q10.1 (G), RN3.4 (R4.1)
unnamed: Q10.2 (S), R20.1

Notes on the sheet:
Input Decoder
Enable Logic
~{out_{000}}
Help Signals: F := in Fault configuration READY := System Ready to be started Logic Rules: // all contacts need to be in their normal/unpowered state // WD is normally HIGH when unpowered READY = ~{E-STOP} ∧ ~{P1} ∧ ~{P2} ∧ WD All individual Fault conditions: F1 = (E-STOP ∧ ¬(~{P1} ∧ ~{P2} ∧ WD) //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
OR Gates
LEDs: Operation State
Singal Describtion: - ~{P1} and ~{P2}: Power relais (-Q4G7 & -Q4G8) => HIGH = Contacts opend and bus unpowered => HiZ = Contacts closed and bus powered - WD: Watchdog relais (-K5E13) => HIGH = Watchdog tripped and Load bus unpowered => HiZ = All OK and Load bus powered - E-STOP: (Emergency-) Stop b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
LEDs: Fault Code
Inverters
Input Pull Downs & Indicator LEDs
Note: All the CD4xxx family ICs register a high-level as low as -3V below 12V. Therefor OR-ing together signals via diodes can be achieved as long as the accumulated voltage drop along a signal is less than the 3V minus a safty margin. With Schottky diods of V_{F} of about 0.7V a line can handle up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

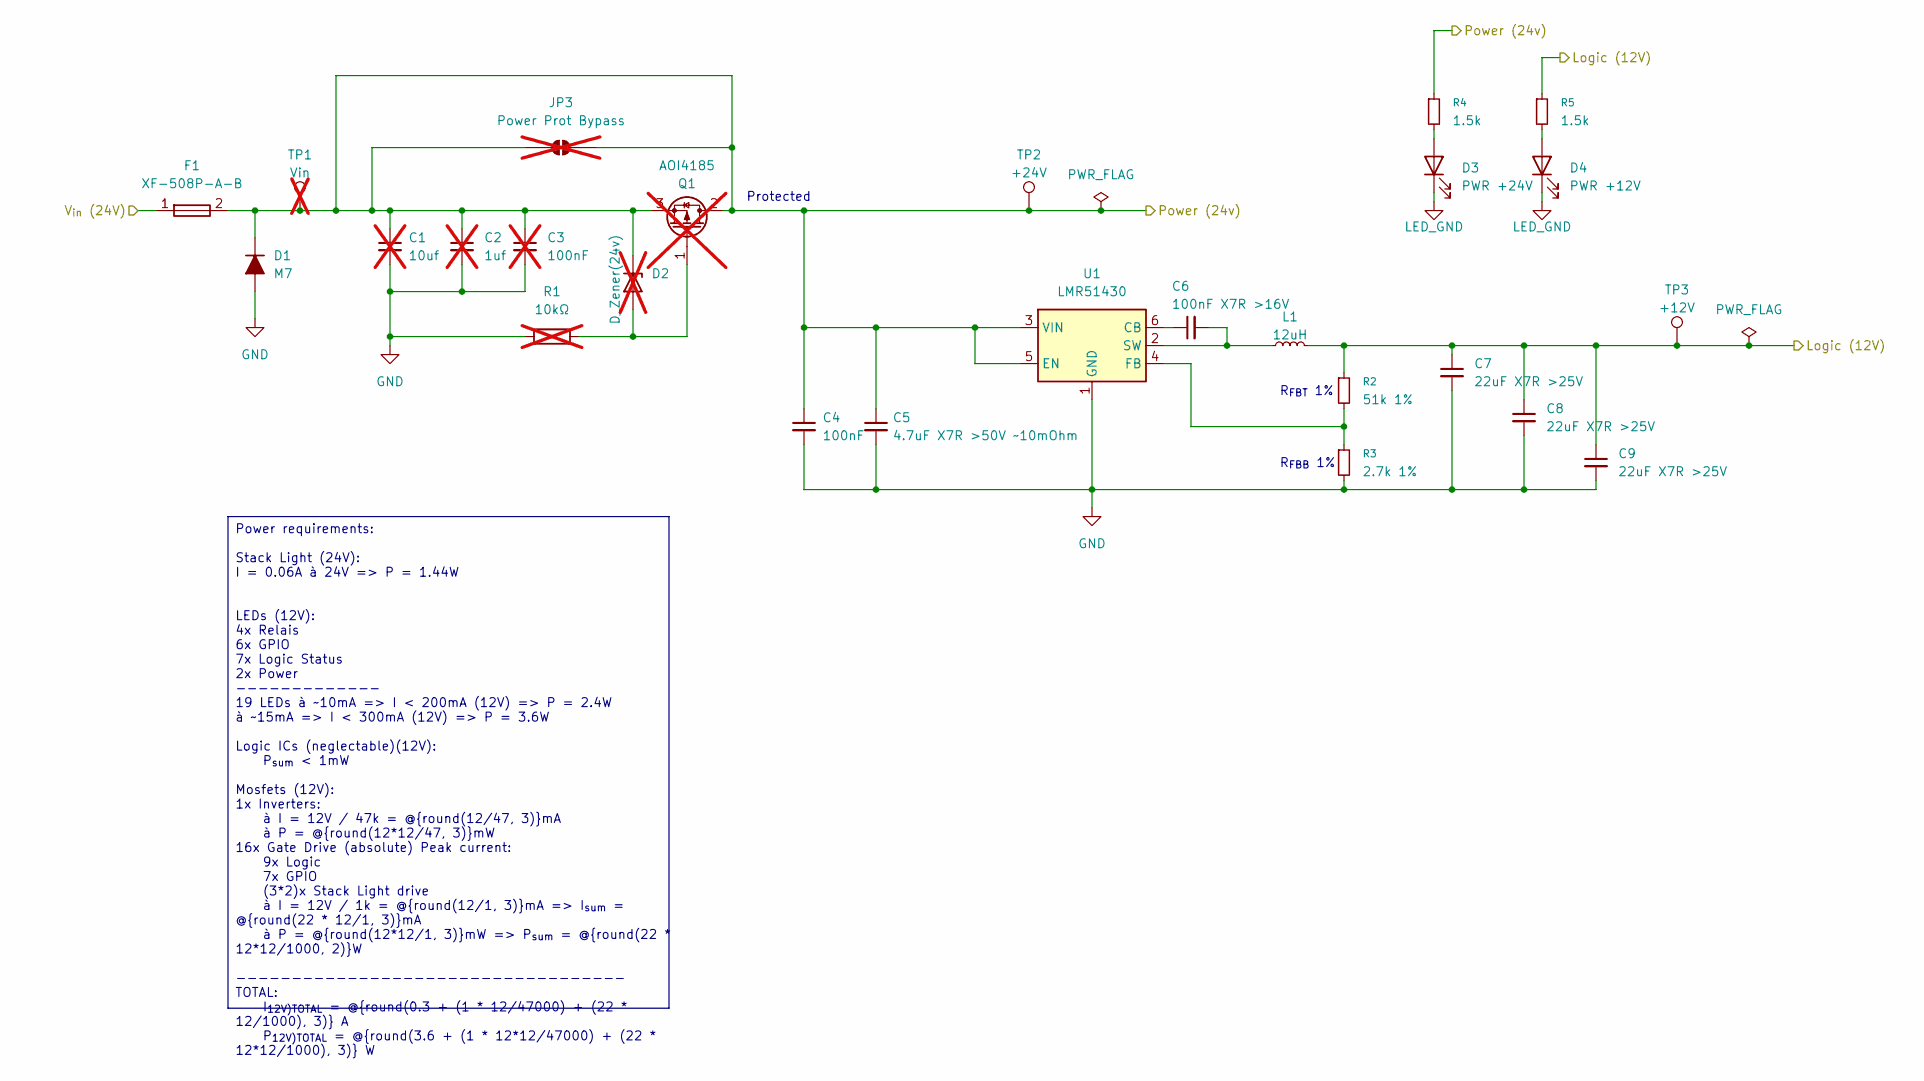
[picture p36: schematic power.kicad_sch, SLCU (Stack Light Control Unit)]

Parts:
C1: 10uf; C_0805_2012Metric; not fitted
C2: 1uf; C_0805_2012Metric; not fitted
C3: 100nF; C_0805_2012Metric; not fitted
C4: 100nF; C_0805_2012Metric_Pad1.18x1.45mm_HandSolder
C5: 4.7uF X7R >50V ~10mOhm; C_1206_3216Metric
C6: 100nF X7R >16V; C_0805_2012Metric
C7, C8, C9: 22uF X7R >25V; C_0805_2012Metric_Pad1.18x1.45mm_HandSolder
D1: M7; D_SMA
D2: D_Zener(24v); D_0805_2012Metric_Pad1.15x1.40mm_HandSolder; not fitted
D3: PWR +24V; LED_0805_2012Metric_Pad1.15x1.40mm_HandSolder
D4: PWR +12V; LED_0805_2012Metric_Pad1.15x1.40mm_HandSolder
F1: XF-508P-A-B; FUSE-TH_XF-508P-A-B; MPN XF-508P-A-B; LCSC Part C19727304
JP3: Power Prot Bypass; SolderJumper-2_P1.3mm_Open_RoundedPad1.0x1.5mm; not fitted
L1: 12uH; L_12x12mm_H8mm; MPN CDRH127NP-120MC; LCSC Part C338772
Q1: AOI4185; TO-251-3_Vertical; not fitted
R1: 10kΩ; R_0805_2012Metric_Pad1.20x1.40mm_HandSolder; not fitted
R2: 51k 1%; R_0805_2012Metric_Pad1.20x1.40mm_HandSolder
R3: 2.7k 1%; R_0805_2012Metric_Pad1.20x1.40mm_HandSolder
R4, R5: 1.5k; R_0805_2012Metric_Pad1.20x1.40mm_HandSolder
TP1: Vin; TestPoint_Pad_D1.5mm; not fitted
TP2: +24V; TestPoint_Pad_D1.5mm
TP3: +12V; TestPoint_Pad_D1.5mm
U1: LMR51430; SOT-23-6

Connections:
+12V: C7.1, C8.1, C9.1, L1.2, R2.1, R5.1, TP3.1 (1_1); also elsewhere on the board
+24V: C1.1, C2.1, C3.1, C4.1, C5.1, D1.1 (K), D2.1 (K), F1.2, JP3.1 (A), JP3.2 (B), Q1.2 (D), Q1.3 (S), R4.1, TP1.1, TP2.1 (1_1), U1.3 (VIN), U1.5 (EN); also elsewhere on the board
/Power/V_{in} (24V): F1.1; also elsewhere on the board
GND: C1.2, C2.2, C3.2, C4.2, C5.2, C7.2, C8.2, C9.2, D1.2 (A), R1.2, R3.2, U1.1 (GND); also elsewhere on the board
LED_GND: D3.1 (K), D4.1 (K); also elsewhere on the board
unnamed: D2.2 (A), Q1.1 (G), R1.1
unnamed: D3.2 (A), R4.2
unnamed: D4.2 (A), R5.2
unnamed: C6.1, U1.6 (CB)
unnamed: R2.2, R3.1, U1.4 (FB)
unnamed: C6.2, L1.1, U1.2 (SW)

Notes on the sheet:
Protected
R_{FBT} 1%
R_{FBB} 1%
Power requirements: Stack Light (24V): I = 0.06A à 24V => P = 1.44W LEDs (12V): 4x Relais 6x GPIO 7x Logic Status 2x Power ------------- 19 LEDs à ~10mA => I < 200mA (12V) => P = 2.4W à ~15mA => I < 300mA (12V) => P = 3.6W Logic ICs (neglectable)(12V): P_{sum} < 1mW Mosfets (12V): 1x Inverters: à I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

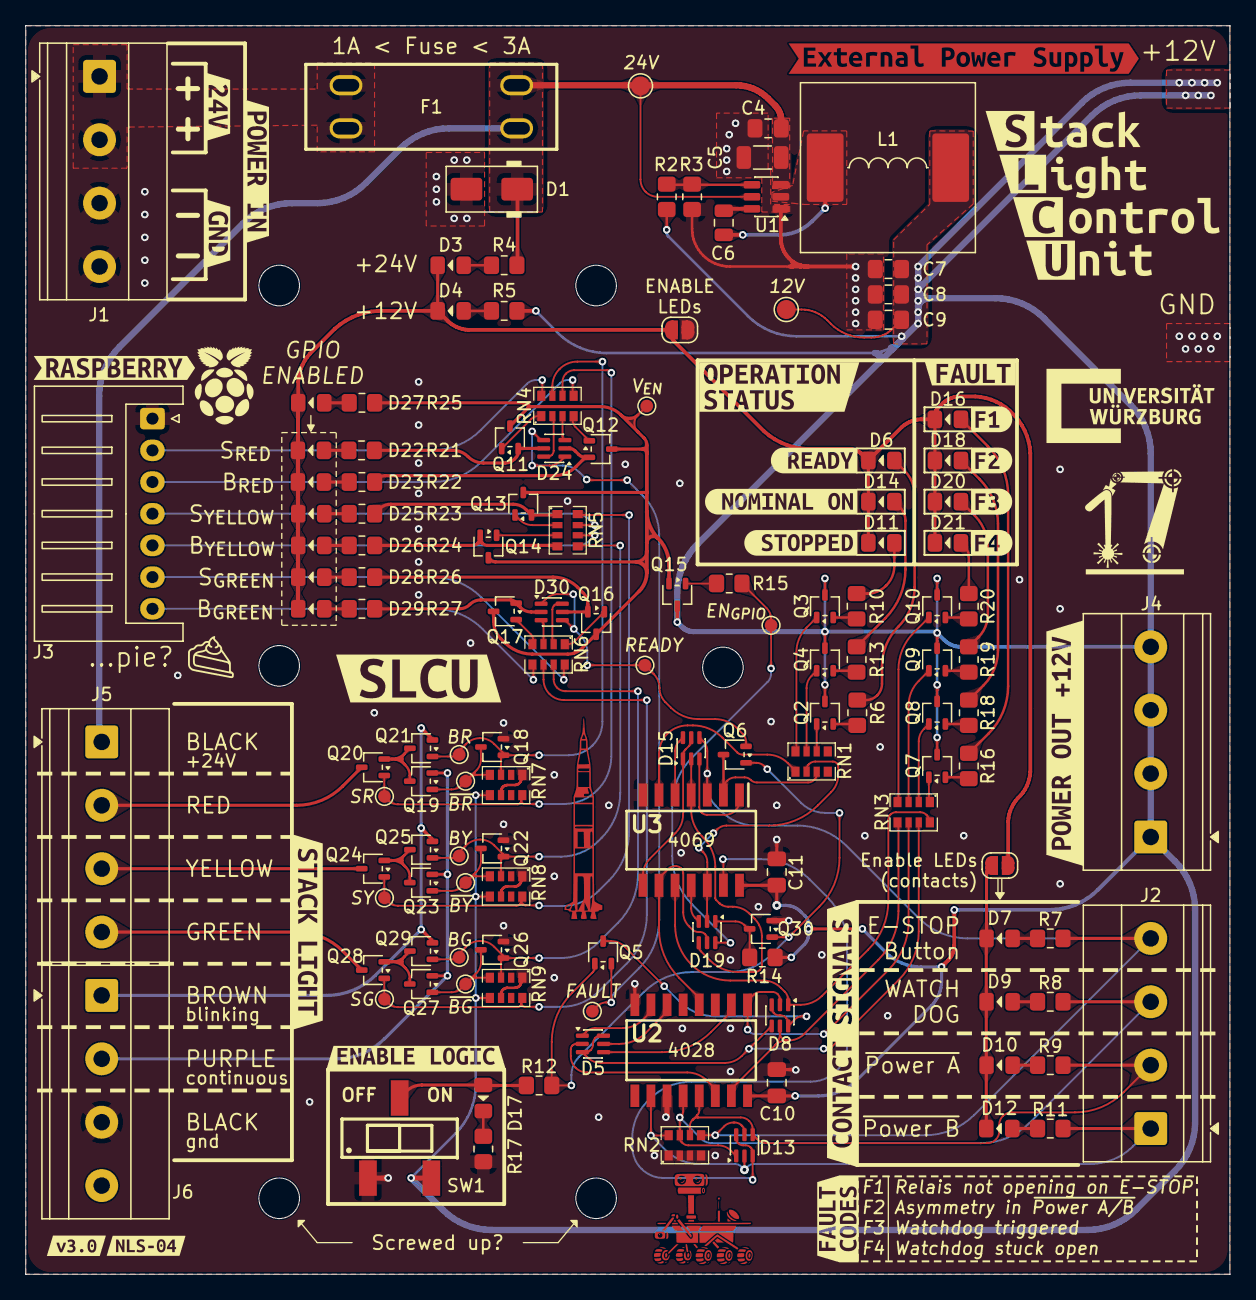
[picture p37: board SLCU.kicad_pcb from above]

Board: 2 copper layers, 95.0 x 98.5 mm, 167 parts (0 on the bottom side), 114 nets.

Other parts of the board:
kibuzzard-6ACFD3B4: G***; kibuzzard-6ACFD3B4
kibuzzard-6ACFD63A: G***; kibuzzard-6ACFD63A
kibuzzard-6ACFD560: G***; kibuzzard-6ACFD560
kibuzzard-6ACFDAEA: G***; kibuzzard-6ACFDAEA
kibuzzard-6ACFDB30: G***; kibuzzard-6ACFDB30
kibuzzard-6ACFDB37: G***; kibuzzard-6ACFDB37
kibuzzard-6ACFDC5F: G***; kibuzzard-6ACFDC5F
kibuzzard-6ACFDC7C: G***; kibuzzard-6ACFDC7C
kibuzzard-6ACFDC65: G***; kibuzzard-6ACFDC65
kibuzzard-6ACFDC83: G***; kibuzzard-6ACFDC83
kibuzzard-6ACFDD22: G***; kibuzzard-6ACFDD22
kibuzzard-6ACFDD51: G***; kibuzzard-6ACFDD51
kibuzzard-6ACFDDC7: G***; kibuzzard-6ACFDDC7
kibuzzard-6ACFDE5B: G***; kibuzzard-6ACFDE5B
kibuzzard-6ACFDF9B: G***; kibuzzard-6ACFDF9B
kibuzzard-6ACFDF9F: G***; kibuzzard-6ACFDF9F
kibuzzard-6ACFDF95: G***; kibuzzard-6ACFDF95
kibuzzard-6ACFDFA3: G***; kibuzzard-6ACFDFA3
kibuzzard-6ACFDFAE: G***; kibuzzard-6ACFDFAE
kibuzzard-6ACFDFB1: G***; kibuzzard-6ACFDFB1
kibuzzard-6ACFDFBD: G***; kibuzzard-6ACFDFBD
kibuzzard-6ACFDFF0: G***; kibuzzard-6ACFDFF0
kibuzzard-6ACFE1C2: G***; kibuzzard-6ACFE1C2
kibuzzard-6ACFE19D: G***; kibuzzard-6ACFE19D
kibuzzard-6ACFE193: G***; kibuzzard-6ACFE193
kibuzzard-6ACFE465: G***; kibuzzard-6ACFE465
kibuzzard-6AD001C0: G***; kibuzzard-6AD001C0
kibuzzard-6AD01D0B: G***; kibuzzard-6AD01D0B
kibuzzard-6AD0072F: G***; kibuzzard-6AD0072F
kibuzzard-6AD0073C: G***; kibuzzard-6AD0073C
kibuzzard-6AD00824: G***; kibuzzard-6AD00824
