JMUWRobotics/AMADEE-27/charging_station/raspcode/control/system_state.py

"""Zustände der Station.

Aus state_machine.py hierher verschoben, um den Import-Zyklus
state_machine -> control.gpio_manager -> state_machine aufzulösen.
state_machine.py importiert State weiterhin und stellt ihn unter dem alten Namen bereit.
"""
from enum import Enum


class State(Enum):
    BOOT = 1  # Setup state, the station is booting up, initializing and testing all components
    IDLE = 2  # Idle state, the station is ready to accept charging requests
    CHARGING = 3  # Charging state, the station is currently charging a robot
    LOW_BATTERY = 4  # Low battery state, no robot is allowed to charge, but the station is still operational
    LOW_SOLAR_IDLE = 5  # Low solar state, no robot is allowed to charge, but the station is still operational
    LOW_SOLAR_CHARGING = 6  # Low solar state, no robot is allowed to charge, but the station is still operational
    FAULT = 7  # Fault state, an error has occurred and the station is not operational
    DEBUG = 8  # Debug state, for manually setting parameters
