JMUWRobotics/AMADEE-27/(commit log)

2026-06-23 charging station: add initial dpm86 api
2026-06-23 charging station: updated ansi coloring
2026-06-23 charging station: move api
2026-06-23 charging station: simple test
2026-07-01 CS: Wiring DIagram v1.0
2026-07-02 CS: update wiring
2026-08-10 CS: corrected solar fuse rating
2026-09-16 Fix of mppt_yaml configuration
    [system.yaml, vedirectManager.py]
2026-09-22 CS: Added DC and Reworked Callback for MPPT
    [charging_manager.py, vedirectManager.py]
2026-09-22 CS: Added Enums for states and Errors of the mppt
    [vedirectManager.py]
2026-09-23 CS: Charing Manager fixing device call
    [charging_manager.py]
2026-10-13 CS: Restructure of Charging Manager
2026-10-13 CS: Restructure of Charging Station
2026-10-16 cs: added KiCad SLCU
2026-10-17 cs: corrected wrong mosfets on SLCU
2026-10-17 cd: hat: finalized schematic + rough layout
2026-10-18 Added new features to the charging station control
2026-10-20 cs: finalized KiCad files
2026-10-29 CS: Current Version running on PI
